jjjjj-enterprises/sienna_camper/window_vent_pattern.pdf

# WAVE 3 Window Vent Panel — full-size cut pattern

Driver-side sliding door, Appendix J (Option B). Panel 34 11/16" x 9 3/4"; intake 6 1/8", exhaust 5 1/16", centers 4 7/8" down, 9 11/32" in from each end, 16" apart.

1. Print double-sided (flip on SHORT edge), Letter, landscape, at 100% / Actual size, NOT Fit. Check the 1" square below.
2. On pages B-D and row 2, cut off the margin on the dashed TRIM line (left edge, and top edge on row 2).
3. Row 1: lay B1's trimmed edge on A1's blue line, match the targets and lines (hold to a window), then C1, D1.
Tape each seam on the back where the backs show the tape strip. Row 2 the same, then onto row 1's bottom strip.
4. Lay the pattern on the poster board with the INSIDE FACE up, square to a factory corner if you can.
Tape it down all round. Hold the overlap's board edge flat where it crosses the intake hole.
5. Cut the outer black line through pattern and board with a box cutter and straightedge.
6. Cut the holes on the red dashed circles first (1/8" small). Open them up to the black line as you fit the collars.
7. Blue dashed lines are where the channels and glass grip the panel. They are not cut lines.
8. Peel the pattern off, or leave it on and write the fit results on it. Then test-fit in the window (Template sheet).

## Assembly map (inside face up, front of the van on the right)

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
## Lines

### cut (final line)

### rough-cut the holes here first

### channel / glass grip, do not cut

### hole center line

1" square:
check with a ruler
before printing the rest

### (back of the title page, left blank)

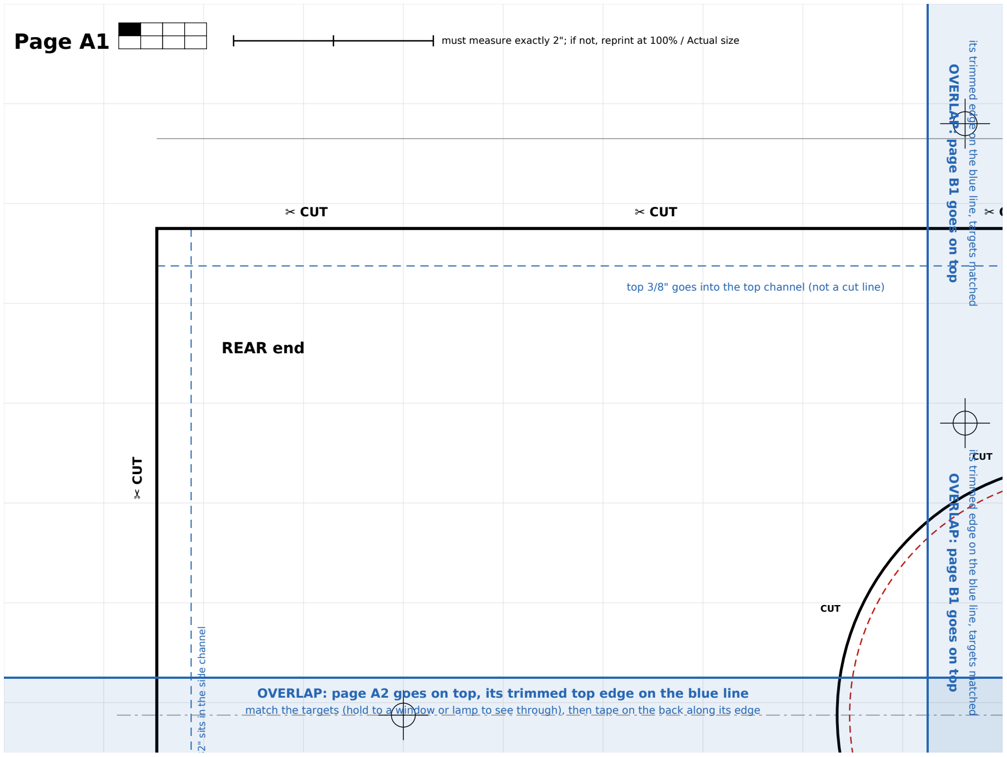
[picture p1: figure]
about 11/32" sits in the side channel; EXHAUST; hole 5 1/16"; rough-cut the red dashed circle first,; CUT; ✂ CUT; OVERLAP: page B1 goes on top

top 3/8" goes into the top channel (not a cut line)

then open up to the black line to fit the collar

REAR end | FRONT end →

its trimmed edge on the blue line, targets matched its trimmed edge on the blue line, targets matched

### OVERLAP: page A2 goes on top, its trimmed top edge on the blue line

match the targets (hold to a window or lamp to see through), then tape on the back along its edge

Page A1 | must measure exactly 2"; if not, reprint at 100% / Actual size

# back of page A1

## the pattern is on the other side · tape the seams on this side

## ◄ TAPE over this edge onto page B1 ◄ TAPE over this edge onto page B1

## ▼ TAPE over this edge onto page A2

If the tape strip isn't along the edge that meets the next page, your printer flipped the other way: tape along that edge anyway.

top 3/8" goes into the top channel (not a cut line)

top 3/8" goes into the top channel (not a cut line)

# EXHAUST

## hole 5 1/16"

rough-cut the red dashed circle first,

then open up to the black line to fit the collar

center

CUT | CUT

CUT

### ✂ CUT

### ✂ CUT

### ✂ CUT

REAR end | FRONT end →

panel 34 11/16" x 9 3/4" · holes 4 7/8" down, 9 11/32" in from each end OVERLAP: page C1 goes on top its trimmed edge on the blue line, targets matched OVERLAP: page C1 goes on top its trimmed edge on the blue line, targets matched

### OVERLAP: page B2 goes on top, its trimmed top edge on the blue line

match | the targets (hold to a window or lamp | to see through), then tape on the back along its edge

✂ TRIM on the dashed line ✂ TRIM on the dashed line ✂ TRIM on the dashed line

then lay this edge on the blue line of page A1

Page B1 | must measure exactly | 2"; if not, reprint at 100% / Actual size

# back of page B1

## the pattern is on the other side · tape the seams on this side

## ◄ TAPE over this edge onto page C1 ◄ TAPE over this edge onto page C1

## ▼ TAPE over this edge onto page B2

top 3/8" goes into the top channel (not a cut line)

top 3/8" goes into the top channel (not a cut line)

then open up to the black line to fit the collar

| | | | CUT | | | CUT
| | CUT | | | INTAKE
| OVERLAP: page C2 goes on | top, its trimmed top edge on the blue line | | | hole 6 1/8"
match the targets (hold to a window or | | | lamp to see through), then tape on the back along its edge
| | | | | rough-cut the red dashed circle first, | center

### ✂ CUT

### ✂ CUT

### ✂ CUT

REAR end | FRONT end →

### panel 34 11/16" x 9 3/4" · holes 4 7/8" down, 9 11/32" in from each end

### OVERLAP: page D1 goes on top

its trimmed edge on the blue line, targets matched

### OVERLAP: page D1 goes on top

its trimmed edge on the blue line, targets matched

✂ TRIM on the dashed line ✂ TRIM on the dashed line ✂ TRIM on the dashed line

then lay this edge on the blue line of page B1

Page C1 | must measure exactly 2"; if not, reprint at 100% / Actual size

# back of page C1

## the pattern is on the other side · tape the seams on this side

## ◄ TAPE over this edge onto page D1 ◄ TAPE over this edge onto page D1

## ▼ TAPE over this edge onto page C2

top 3/8" goes into the top channel (not a cut line)

about 11/32" sits in the side channel

## hole 6 1/8"

rough-cut the red dashed circle first,

then open up to the black line to fit the collar

CUT | CUT

CUT

### ✂ CUT

### ✂ CUT

### ✂ CUT

### ✂ CUT

REAR end | FRONT | end →

(your right, from inside the van)

OVERLAP: | page D2 goes | on top, its trimmed top edge on the blue line
match the targets (hold to a window or lamp to see through), then tape on the back along its edge

✂ TRIM on the dashed line ✂ TRIM on the dashed line ✂ TRIM on the dashed line

then lay this edge on the blue line of page C1

Page D1 | must measure exactly 2"; if not, reprint at 100% / Actual size

# back of page D1

## the pattern is on the other side · tape the seams on this side

## ▼ TAPE over this edge onto page D2

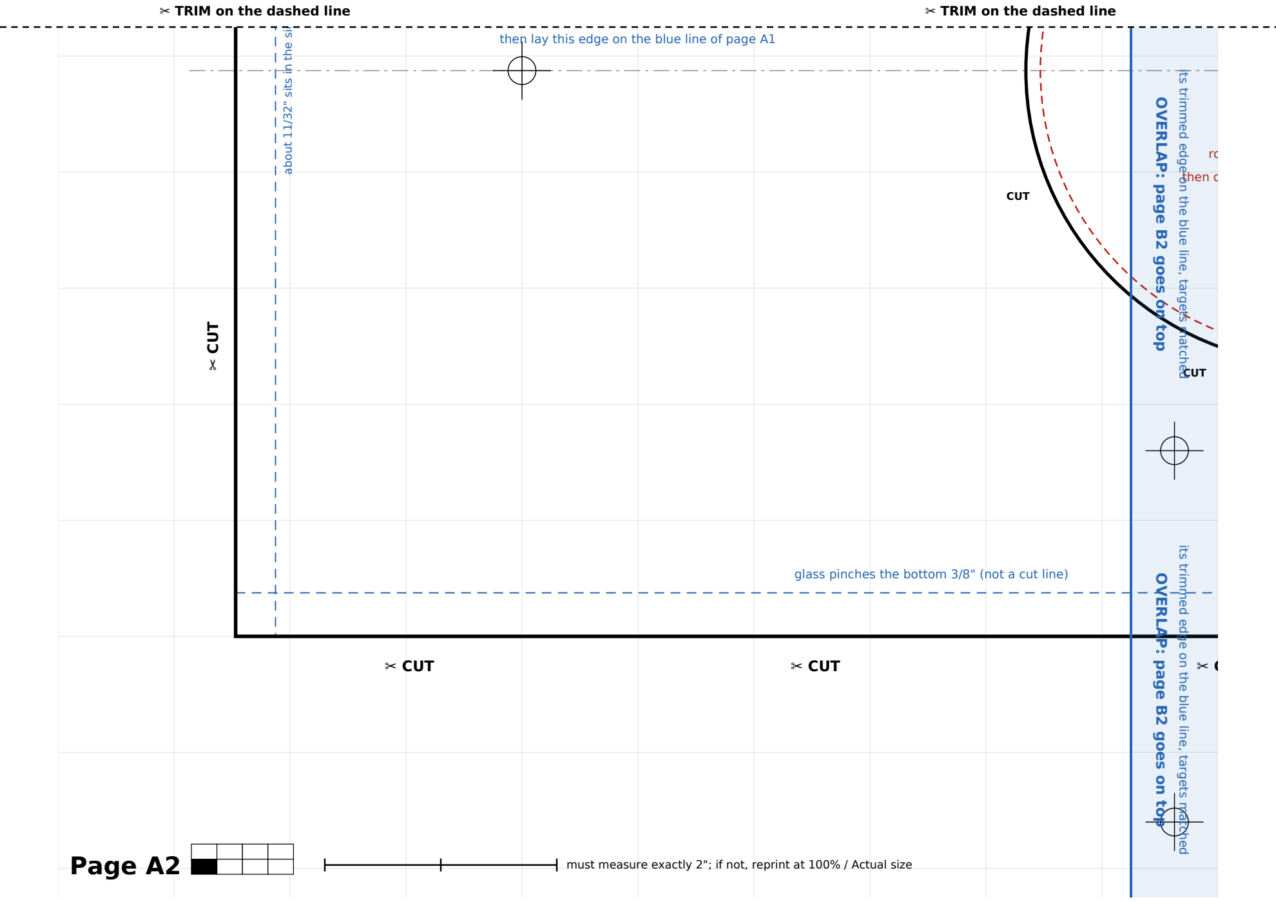
[picture p2: figure]
about 11/32" sits in the side channel; rough-cut the red dashed circle first,; CUT; ✂ CUT; OVERLAP: page B2 goes on top

glass pinches the bottom 3/8" (not a cut line) then open up to the black line to fit the collar

its trimmed edge on the blue line, targets matched its trimmed edge on the blue line, targets matched

✂ | TRIM on the dashed line | ✂ TRIM on the dashed line

then lay this edge on the blue line of page A1

Page A2 | must measure exactly 2"; if not, reprint at 100% / Actual size

# back of page A2

## the pattern is on the other side · tape the seams on this side

## ◄ TAPE over this edge onto page B2 ◄ TAPE over this edge onto page B2

glass pinches the bottom 3/8" (not a cut line) rough-cut the red dashed circle first,

then open up to the black line to fit the collar

center

CUT

CUT | CUT

### ✂ CUT

### ✂ CUT

### ✂ CUT

INSIDE | FACE
centers 16" | apart (check with a tape)

panel 34 11/16" x 9 3/4" · holes 4 7/8" down, 9 11/32" in from each end OVERLAP: page C2 goes on top its trimmed edge on the blue line, targets matched OVERLAP: page C2 goes on top its trimmed edge on the blue line, targets matched

✂ TRIM on the dashed line ✂ TRIM on the dashed line ✂ TRIM on the dashed line

then lay this edge on the blue line of page A2

✂ TRIM on the | dashed line | ✂ TRIM on the dashed line
then lay this edge | on the blue line of page B1
Page B2 | must measure exactly | 2"; if not, reprint at 100% / Actual size

# back of page B2

## the pattern is on the other side · tape the seams on this side

## ◄ TAPE over this edge onto page C2 ◄ TAPE over this edge onto page C2

glass pinches the bottom 3/8" (not a cut line)

glass pinches the bottom 3/8" (not a cut line)

| rough-cut the red dashed circle first, | center
CUT | then open up to the black line to fit the | | collar
CUT | CUT

### ✂ CUT

### ✂ CUT

### ✂ CUT

INSIDE | FACE
centers 16" | apart (check with a tape)

### OVERLAP: page D2 goes on top

its trimmed edge on the blue line, targets matched

### OVERLAP: page D2 goes on top

its trimmed edge on the blue line, targets matched

✂ TRIM on the dashed line ✂ TRIM on the dashed line ✂ TRIM on the dashed line

then lay this edge on the blue line of page B2

✂ TRIM on the dashed line | ✂ TRIM on the dashed line
then lay this | edge on the blue line of page C1
Page C2 | must measure exactly 2"; if not, reprint at 100% / Actual size

# back of page C2

## the pattern is on the other side · tape the seams on this side

## ◄ TAPE over this edge onto page D2 ◄ TAPE over this edge onto page D2

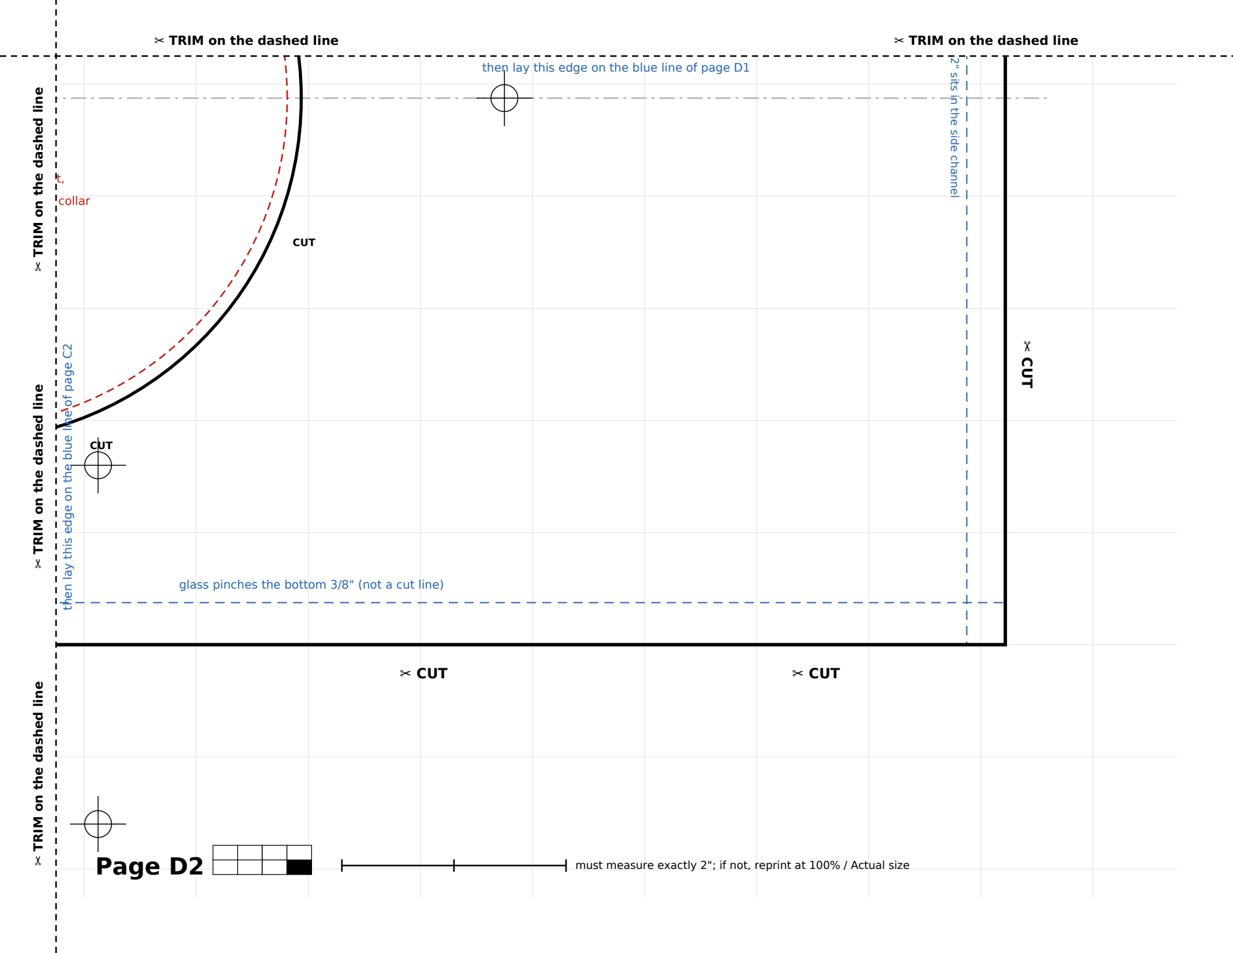
[picture p3: figure]
about 11/32" sits in the side channel; rough-cut the red dashed circle first,; CUT; ✂ CUT; ✂ TRIM on the dashed; line; ✂ TRIM on; the dashed line

glass pinches the bottom 3/8" (not a cut line) then open up to the black line to fit the collar

✂ TRIM on the dashed line ✂ TRIM on the dashed line ✂ TRIM on the dashed line

then lay this edge on the blue line of page C2

then lay | this edge on the blue line of page D1
Page D2 | must measure exactly 2"; if not, reprint at 100% / Actual size

# back of page D2

## the pattern is on the other side · tape the seams on this side

## nothing to tape from this page: tape from C2 and D1 lands here
