jjjjj-enterprises/sienna_camper/photos/ply-02-comb-laid-out.jpg

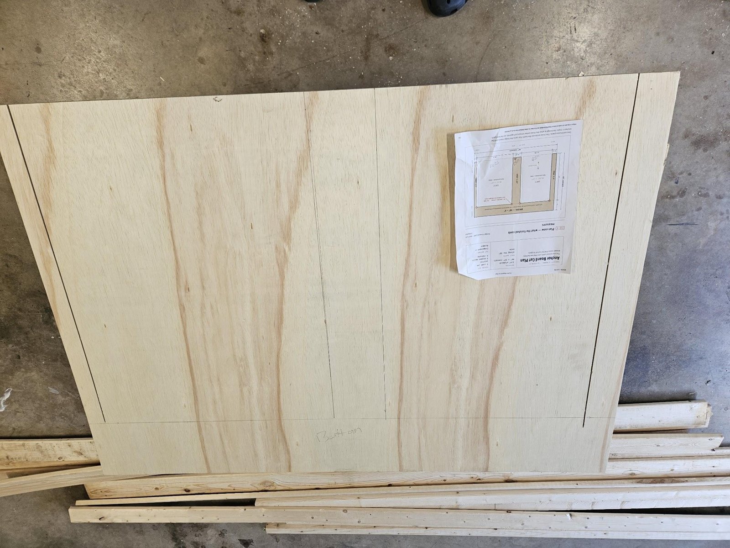
photos/ply-02-comb-laid-out.jpg
