jjjjj-enterprises/sienna_camper/photos/ply-05-comb-cut.jpg

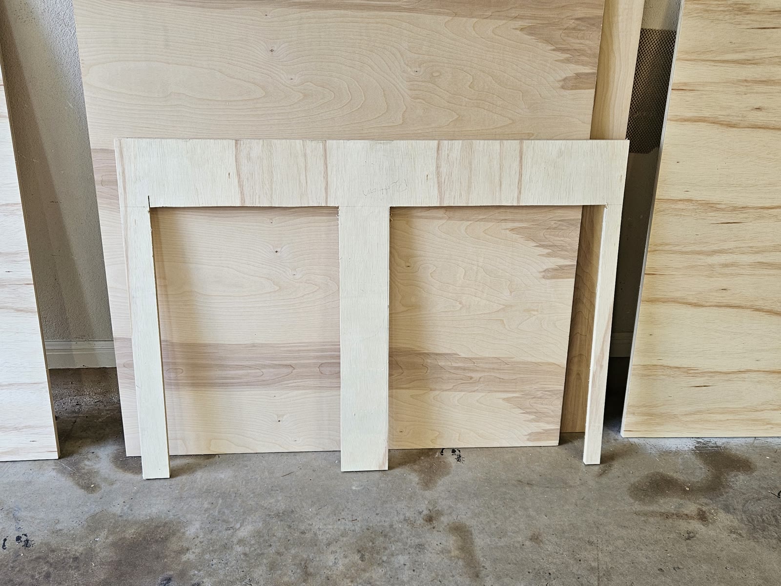
photos/ply-05-comb-cut.jpg
