jjjjj-enterprises/sienna_camper/renders/rear-view-deployed.png

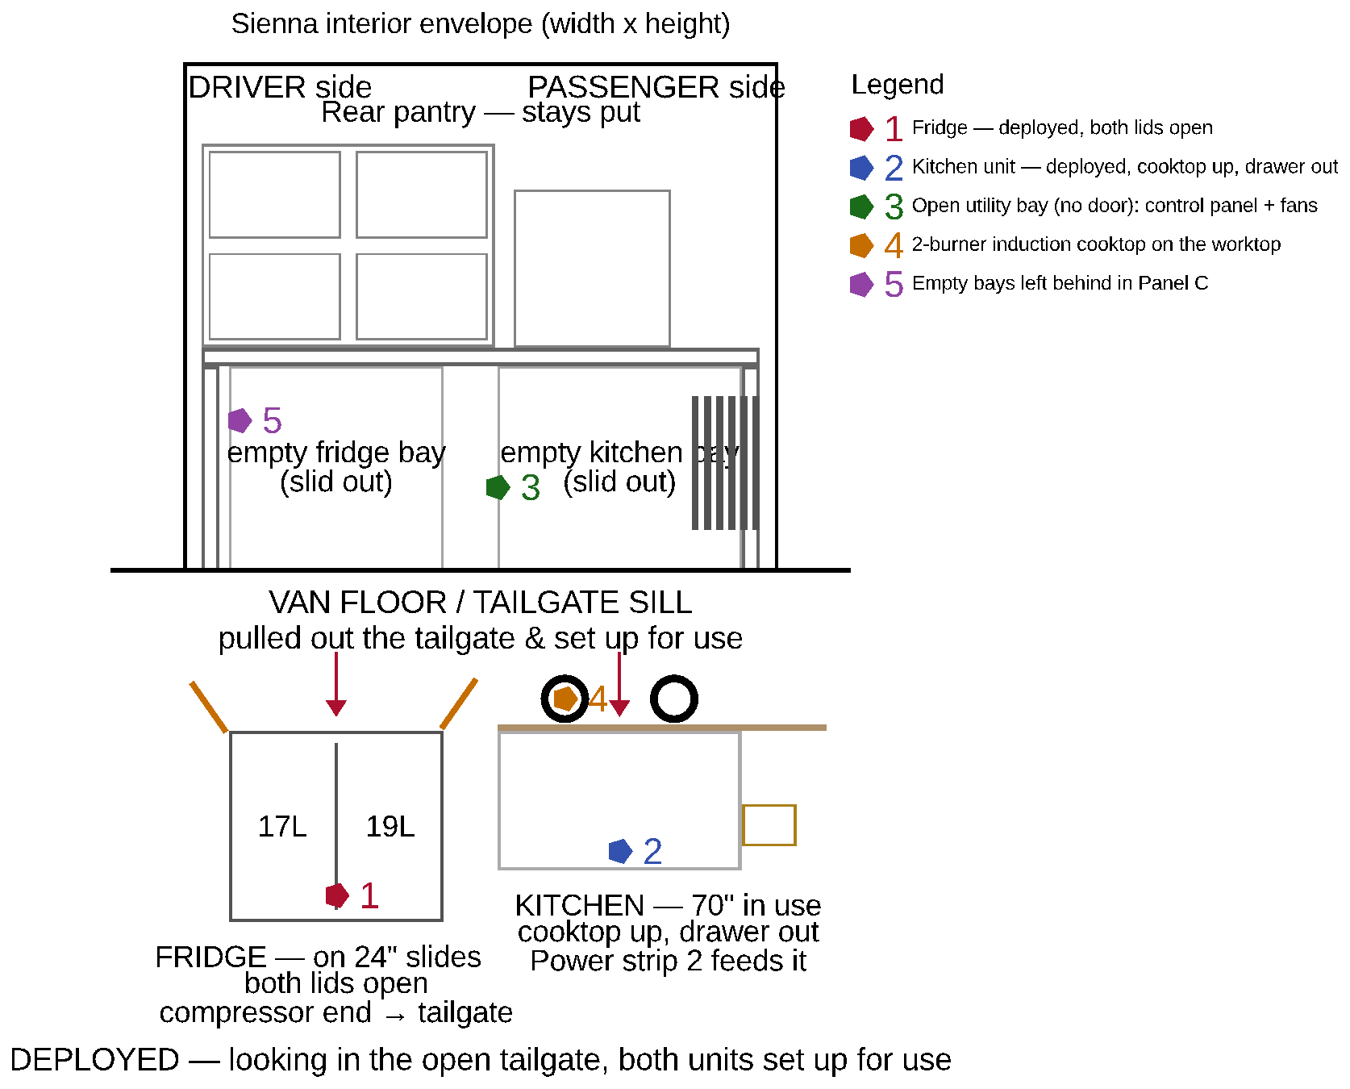
renders/rear-view-deployed.png
