jjjjj-enterprises/sienna_camper/renders/rear-view.png

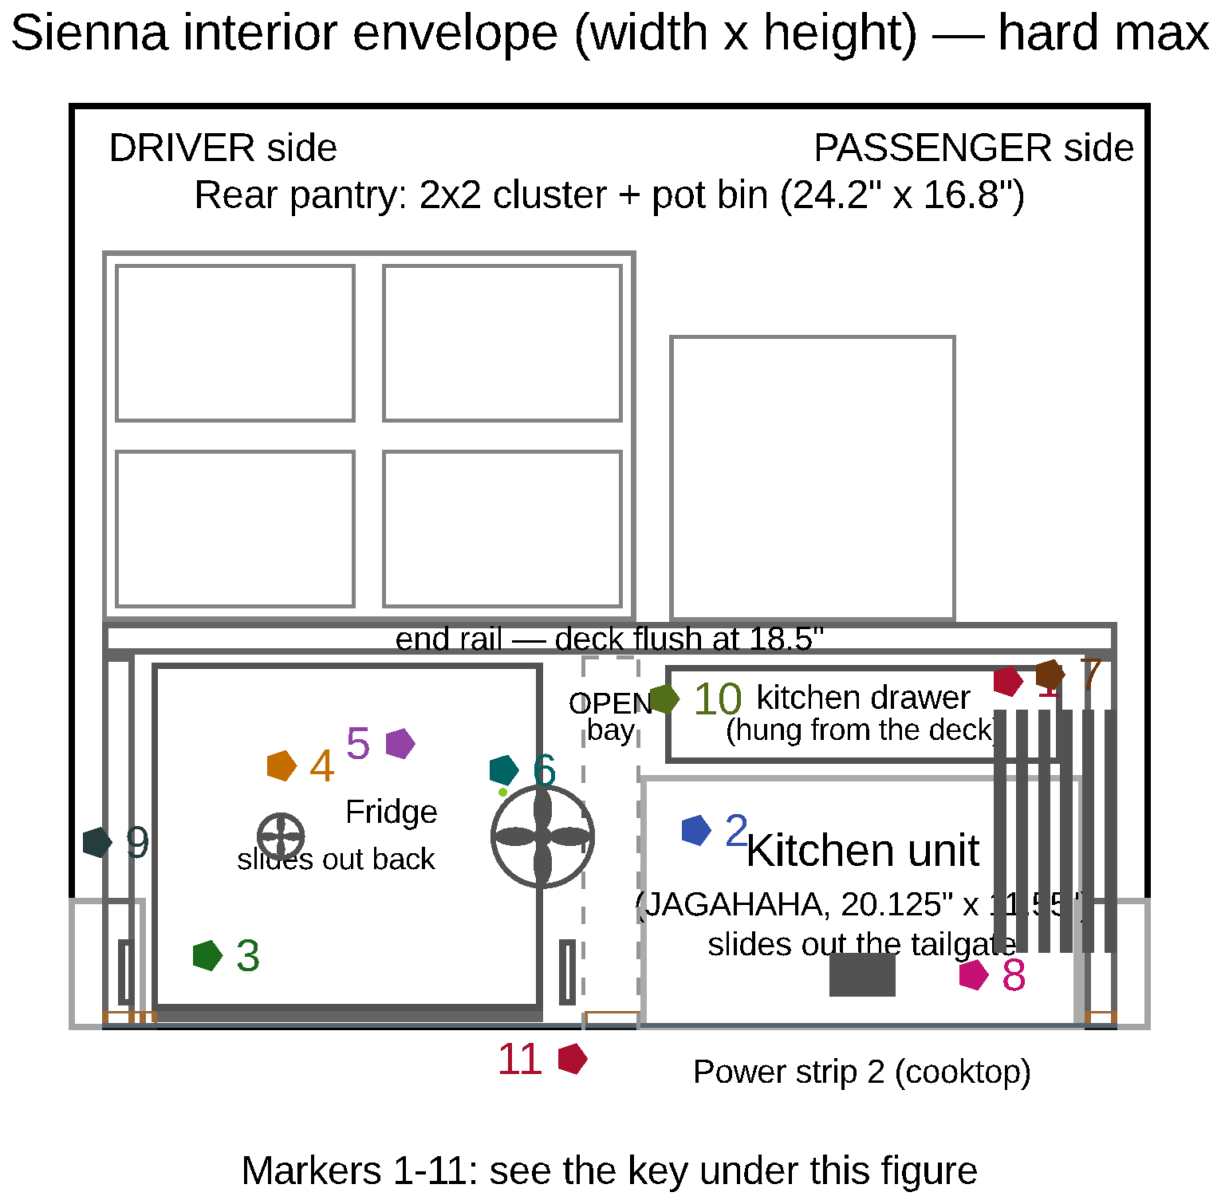
renders/rear-view.png
