jjjjj-enterprises/sienna_camper/renders/sheet-cut-1.png

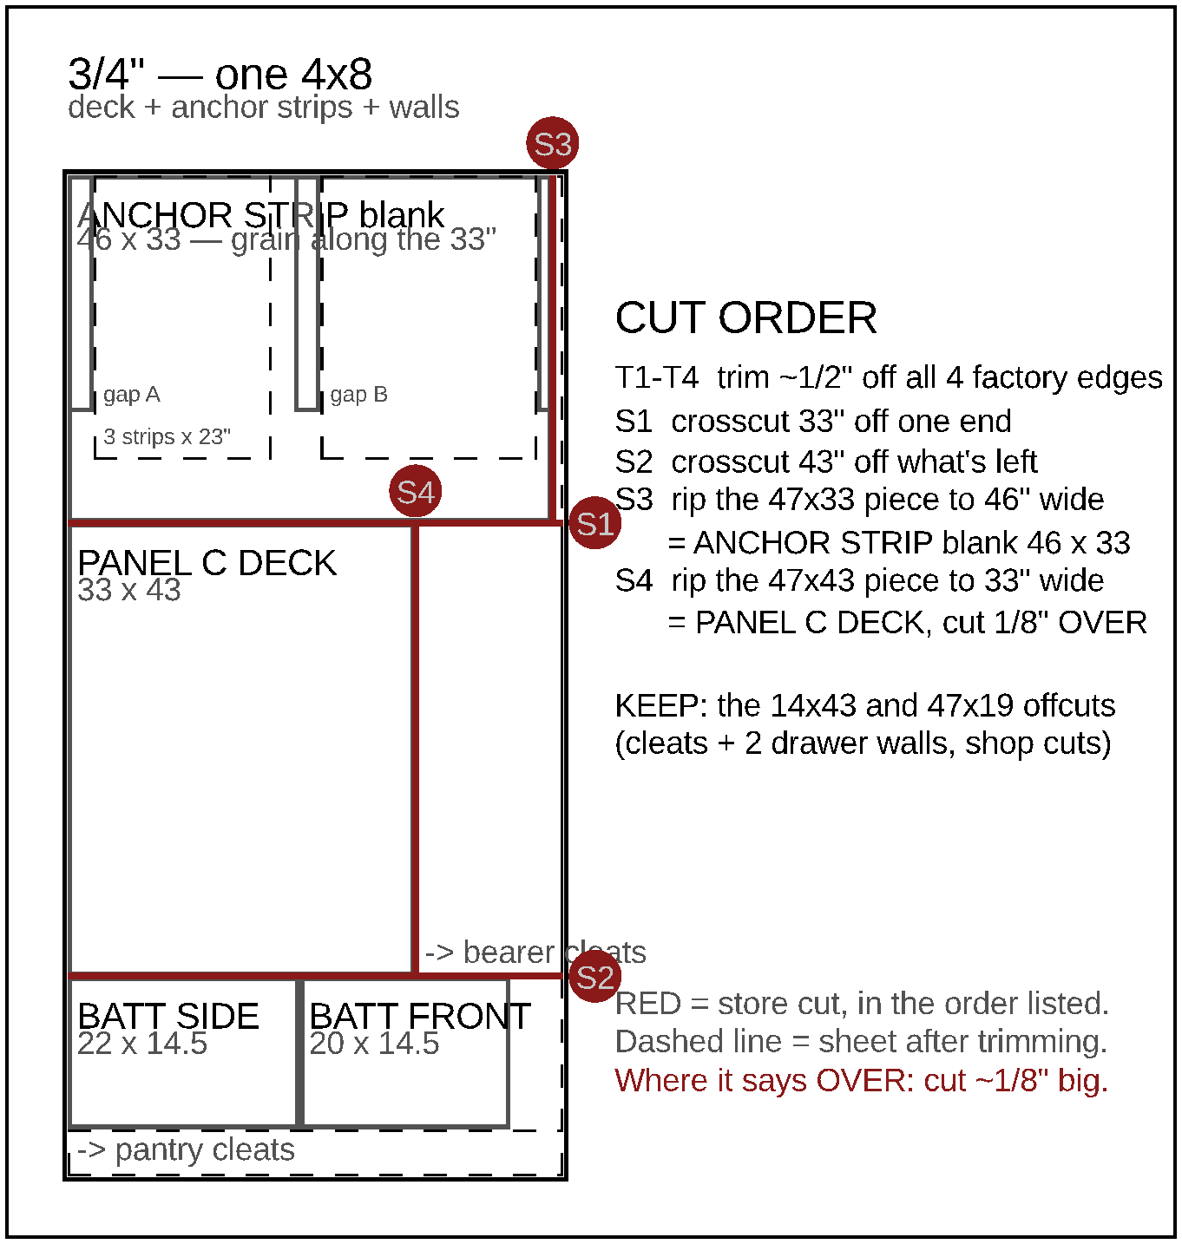
renders/sheet-cut-1.png
