jjjjj-enterprises/sienna_camper/renders/sheet-cut-layout.png

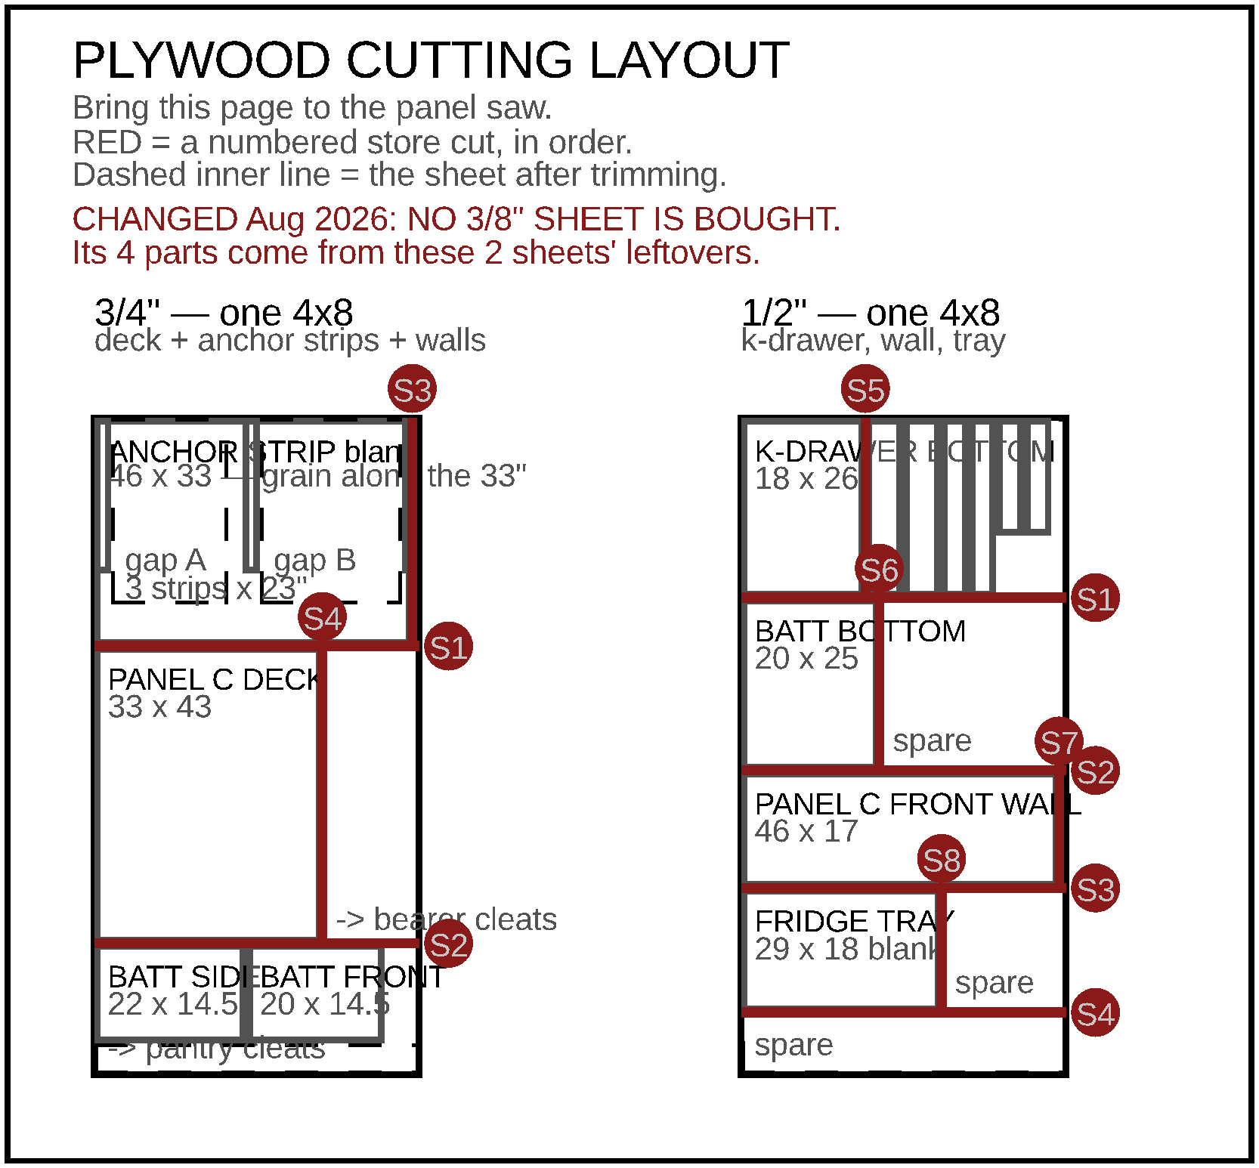
renders/sheet-cut-layout.png
