jjjjj-enterprises/sienna_camper/renders/side-driver.png

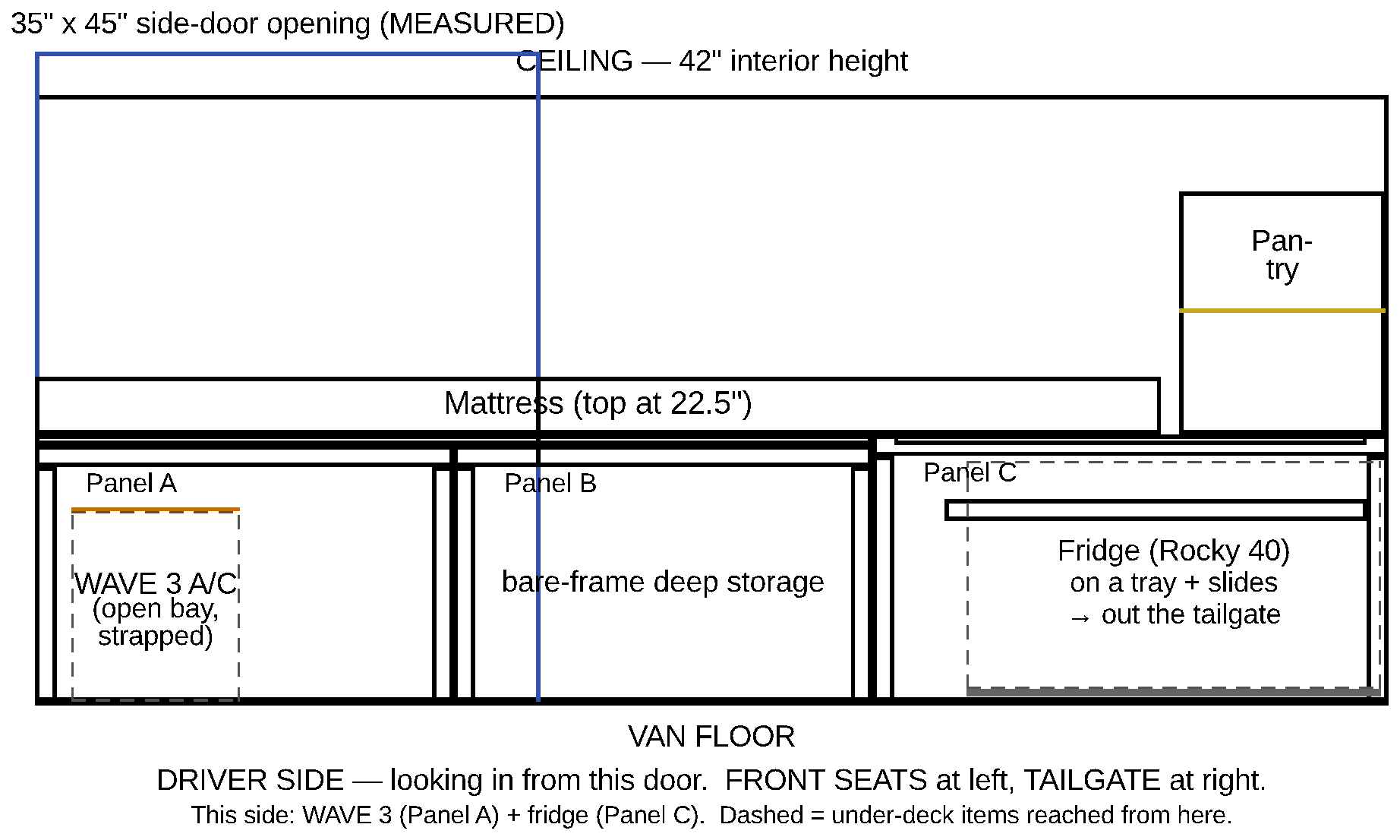
renders/side-driver.png
