jjjjj-enterprises/sienna_camper/renders/side-profile.png

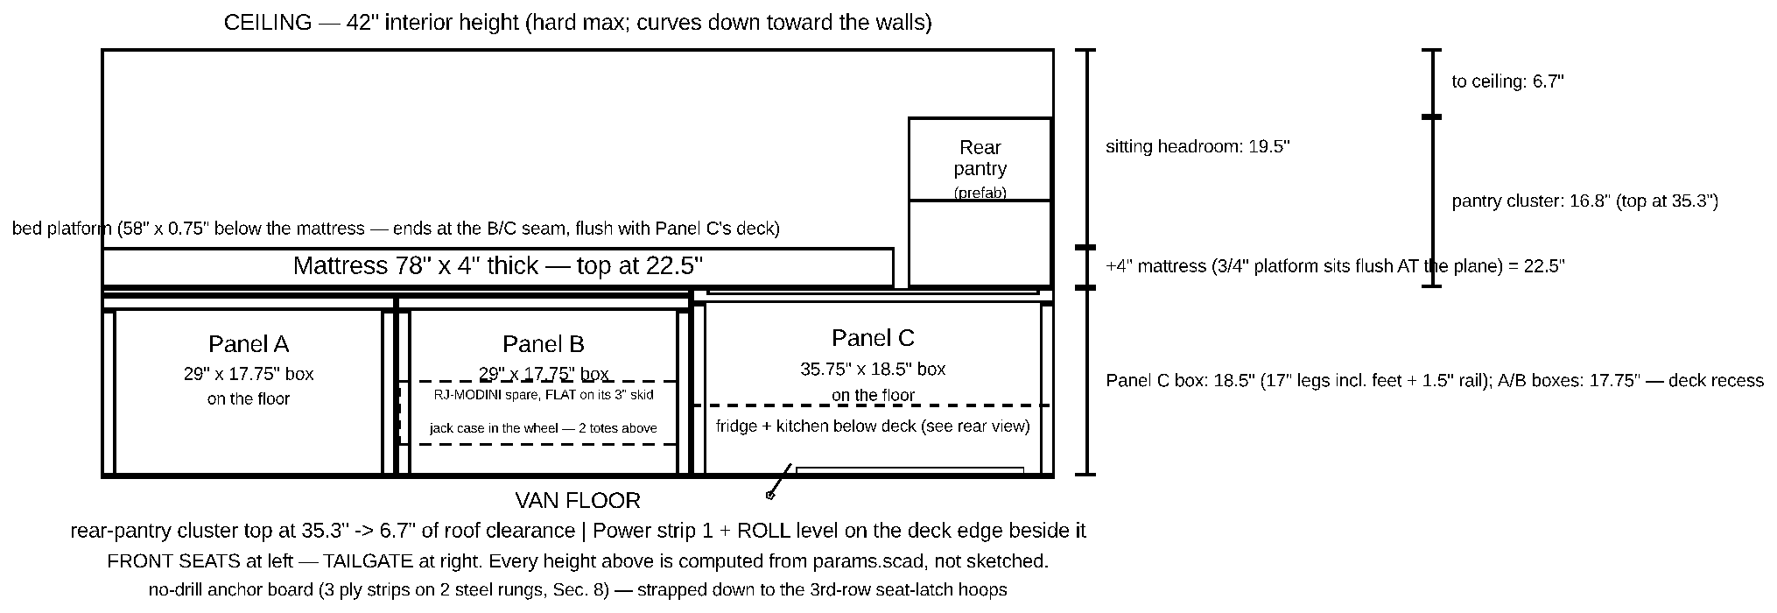
renders/side-profile.png
