jjjjj-enterprises/sienna_camper/renders/top-down.png

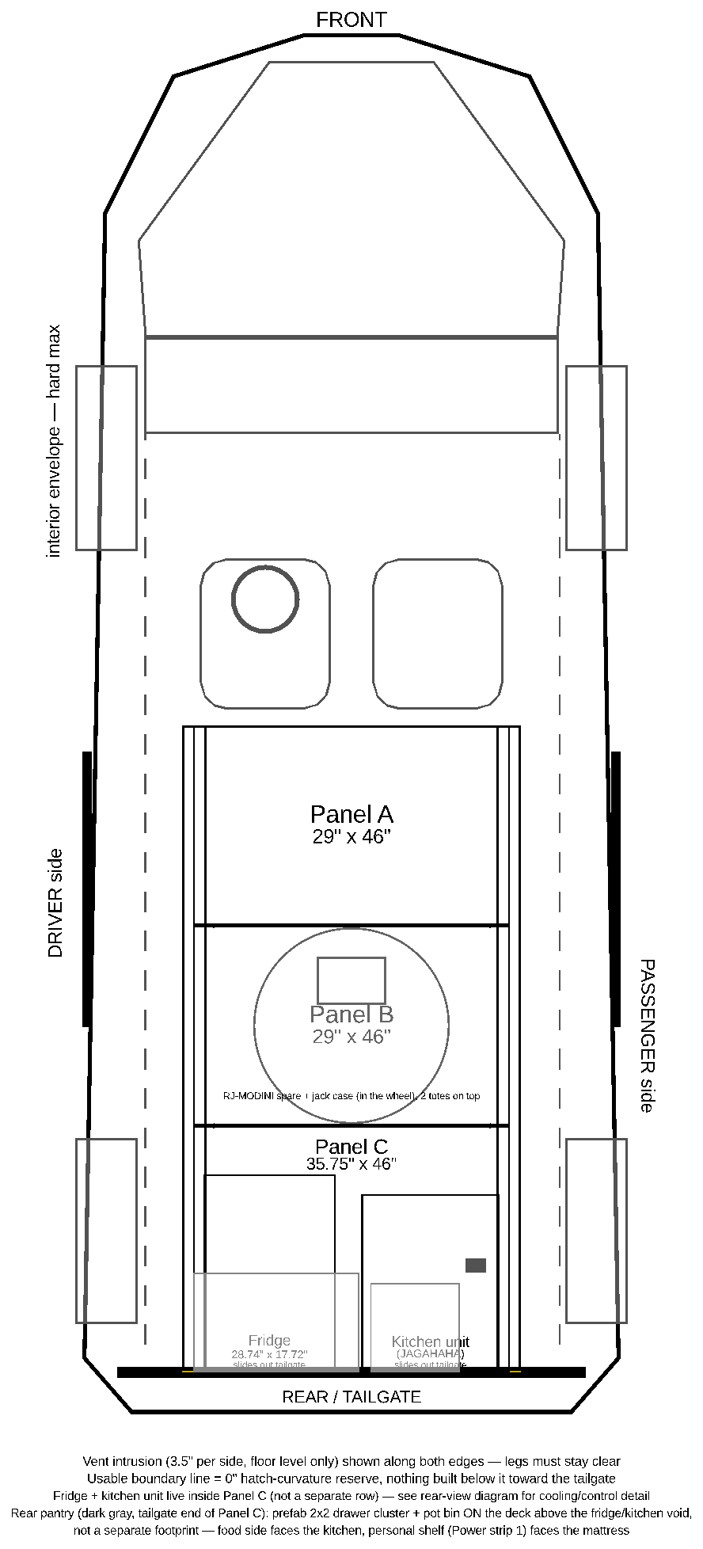
renders/top-down.png
