jjjjj-enterprises/sienna_camper/renders/vanmeas-v1.png

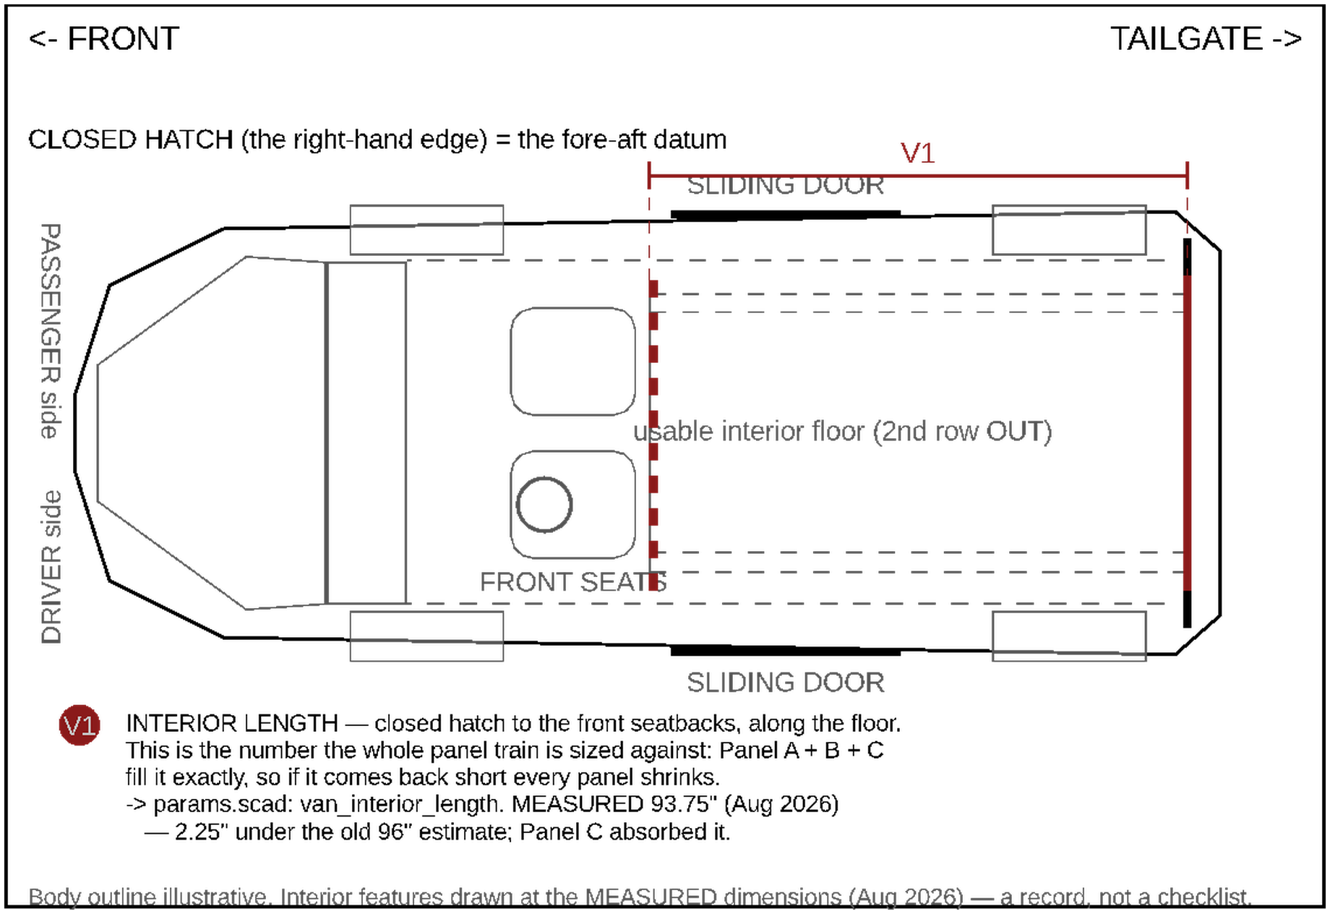
renders/vanmeas-v1.png
