jjjjj-enterprises/sienna_camper/renders/vanmeas-v2.png

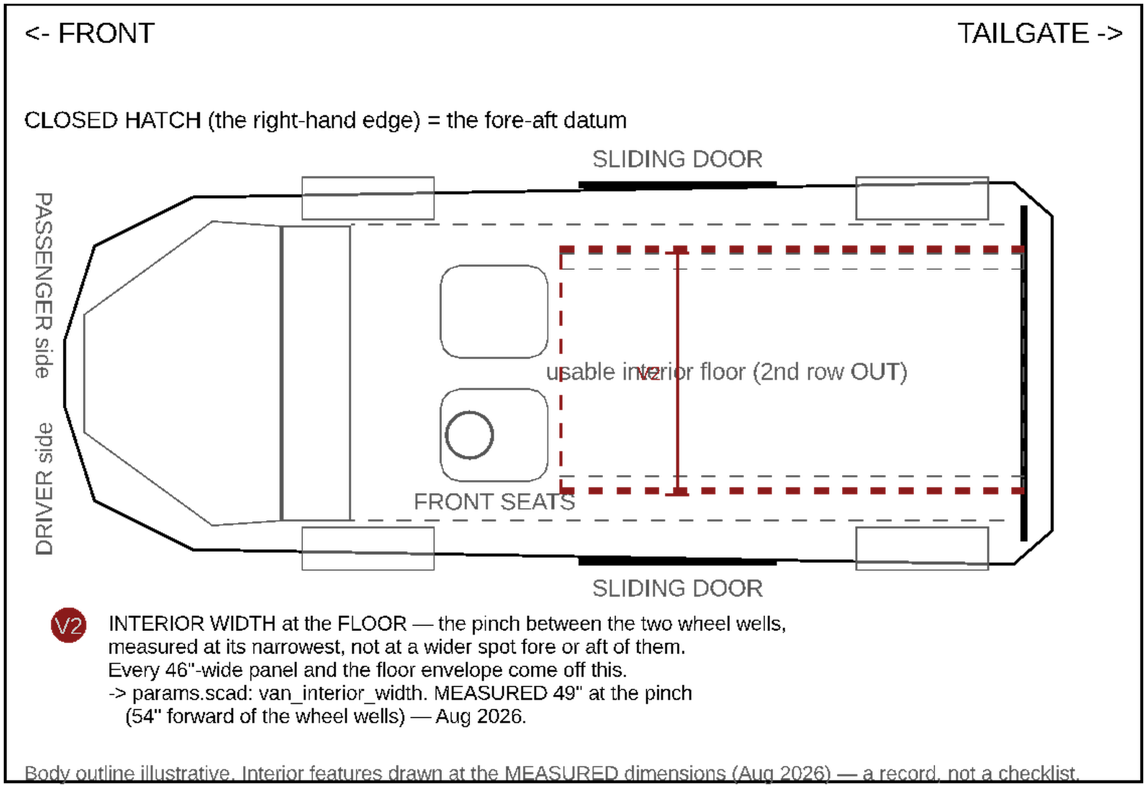
renders/vanmeas-v2.png
