jjjjj-enterprises/sienna_camper/renders/vanmeas-v3.png

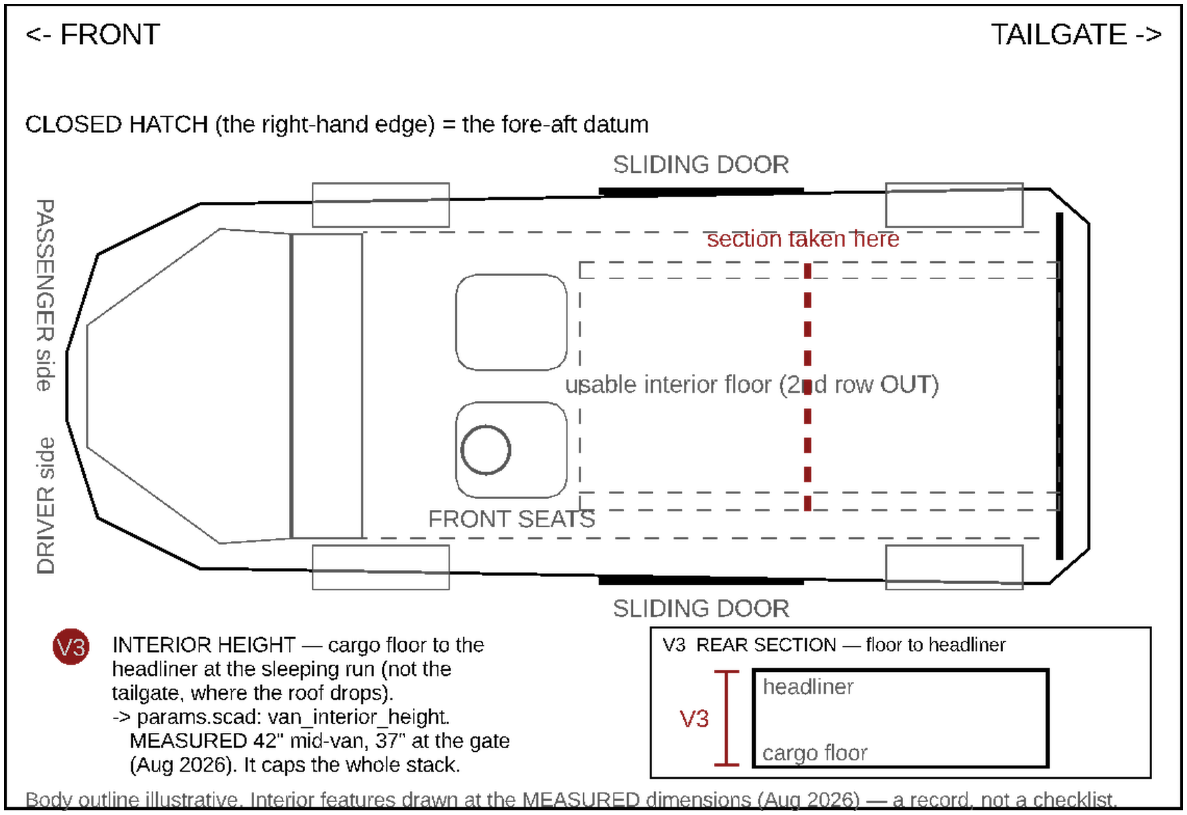
renders/vanmeas-v3.png
