jjjjj-enterprises/sienna_camper/renders/vanmeas-v4.png

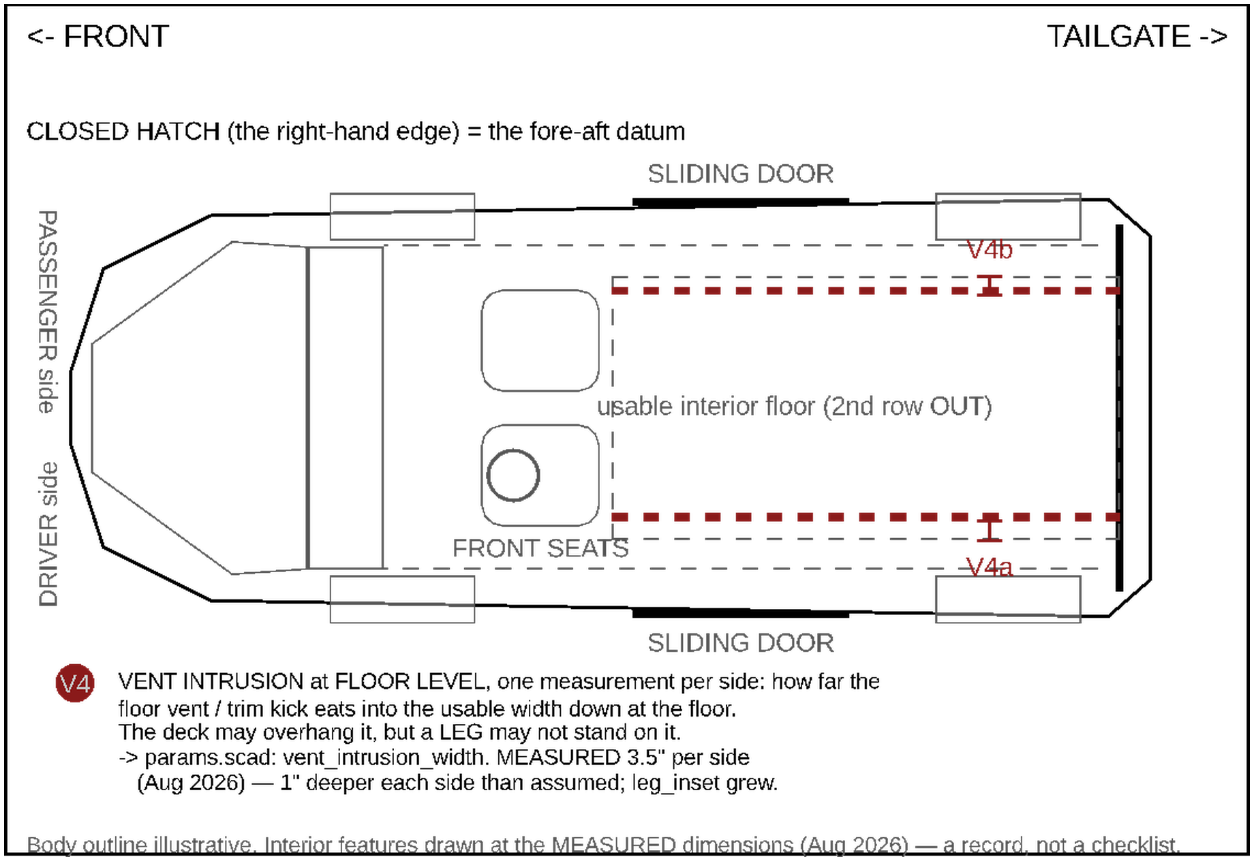
renders/vanmeas-v4.png
