jjjjj-enterprises/sienna_camper/renders/vanmeas-v5.png

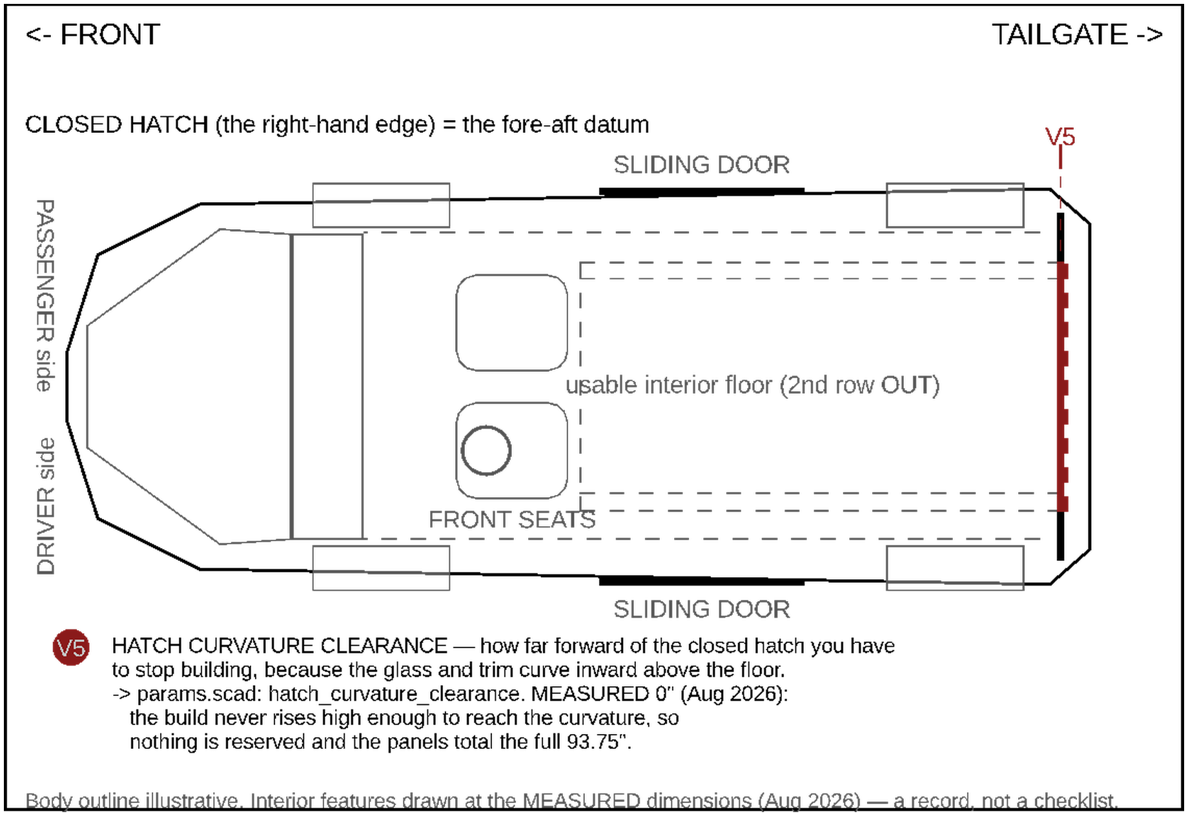
renders/vanmeas-v5.png
