jjjjj-enterprises/sienna_camper/renders/vanmeas-v6.png

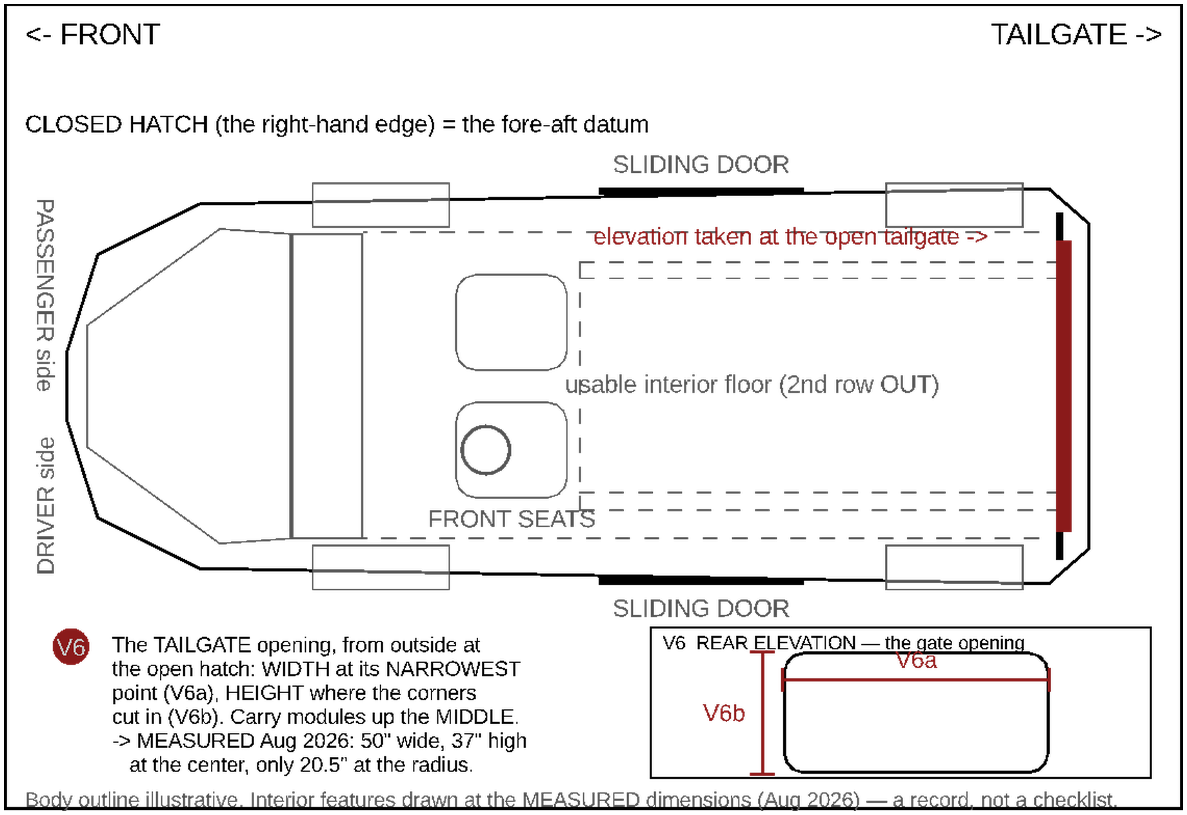
renders/vanmeas-v6.png
