jjjjj-enterprises/sienna_camper/renders/vanmeas-v7.png

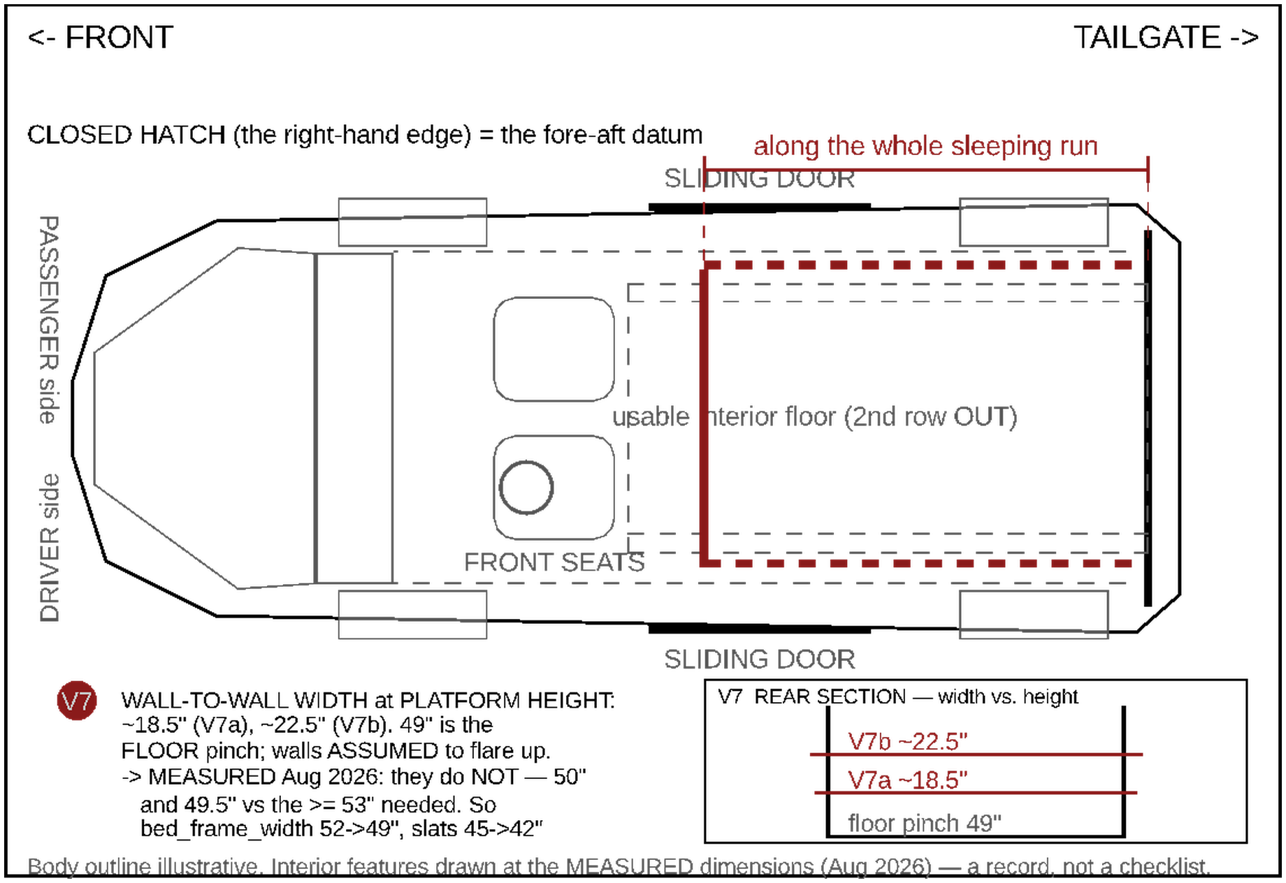
renders/vanmeas-v7.png
