jjjjj-enterprises/sienna_camper/renders/vanmeas-v8.png

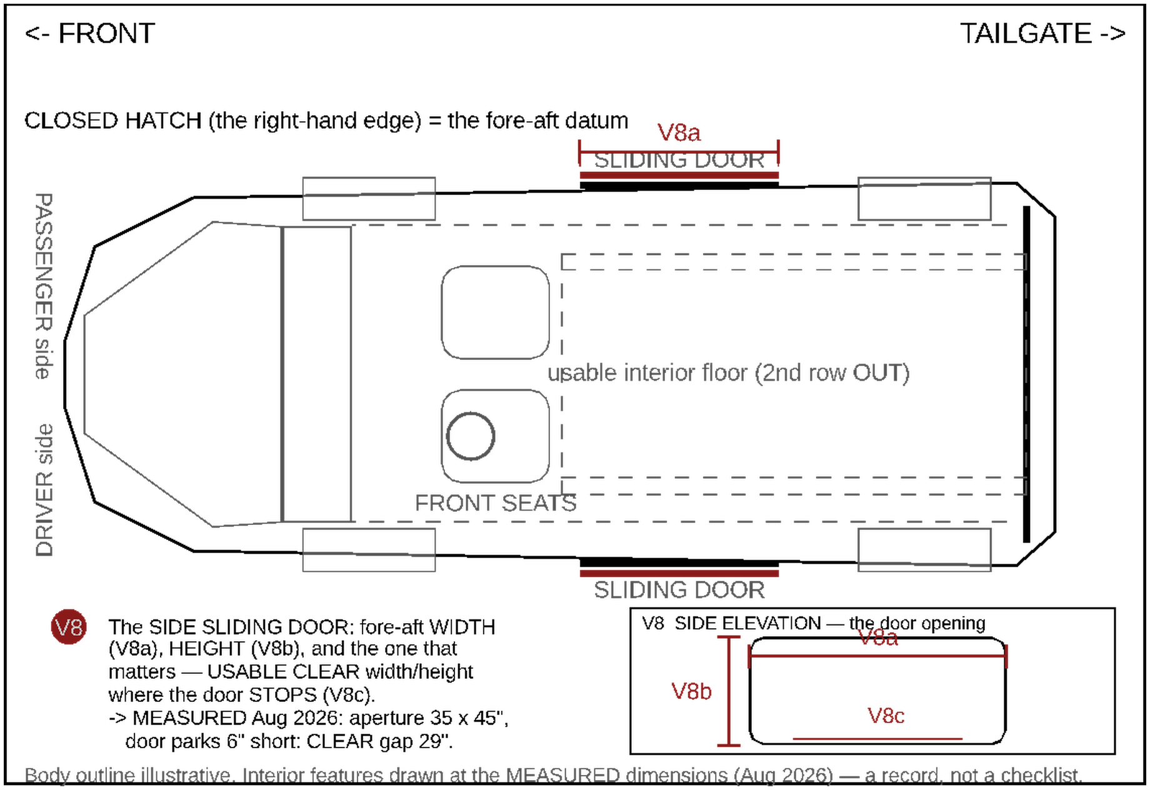
renders/vanmeas-v8.png
