jjjjj-enterprises/sienna_camper/renders/vanmeas-v9.png

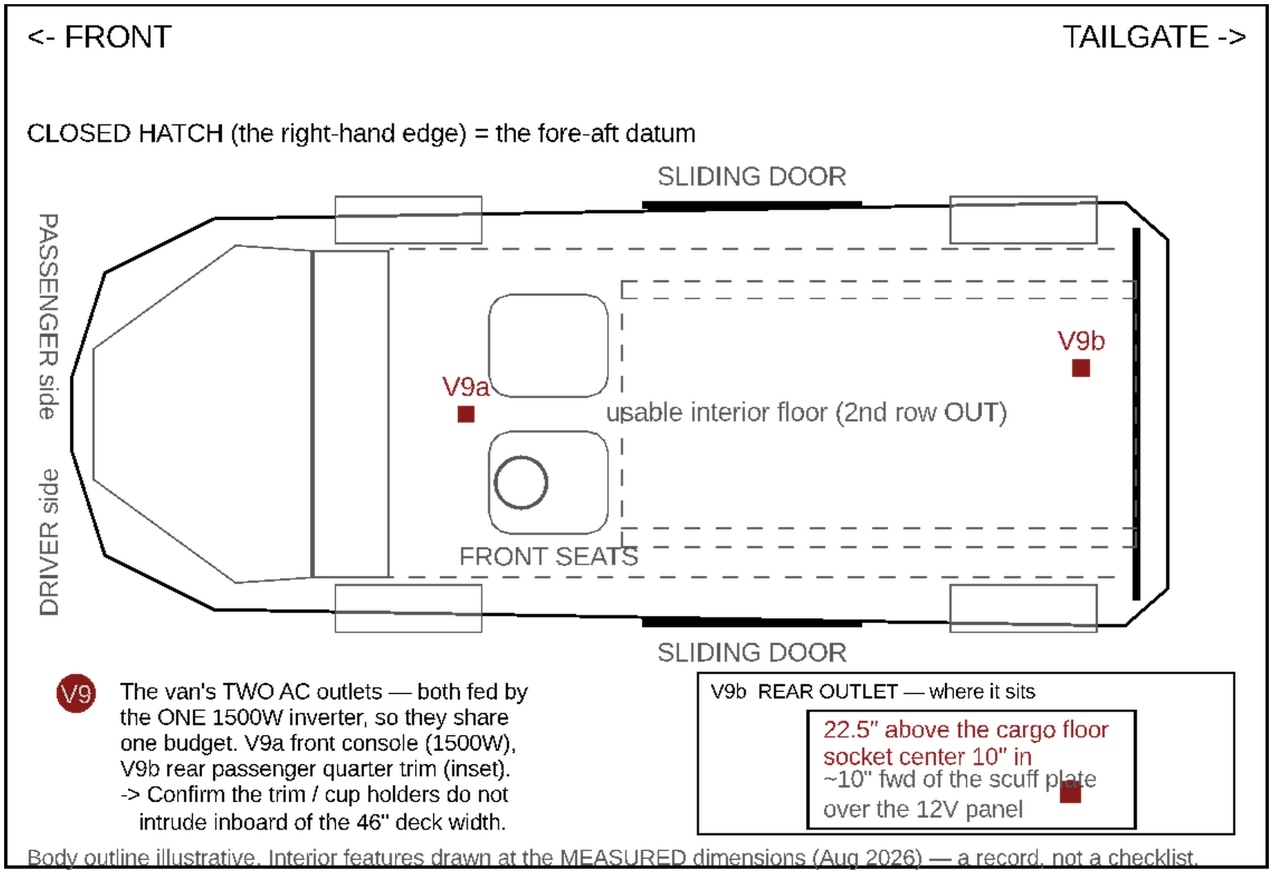
renders/vanmeas-v9.png
