jjjjj-enterprises/sienna_camper/renders/vanmeas-v10.png

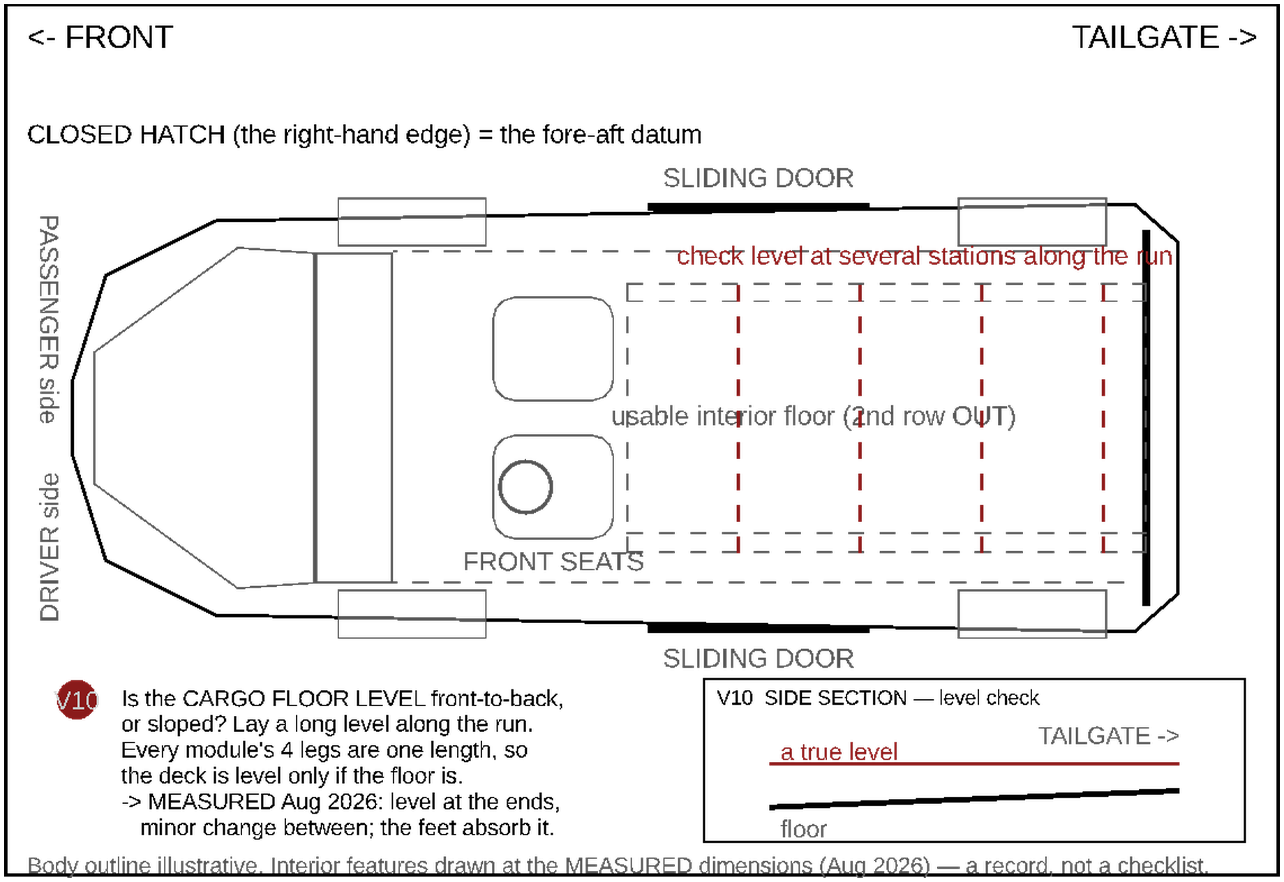
renders/vanmeas-v10.png
