jjjjj-enterprises/sienna_camper/electrical_layout_detail.scad

// ============================================================
// Electrical system layout — icon-based, all purchased parts
// ============================================================
// Every electrical component bought for the build (fans, W1209
// controller, Nilight fuse block, switches, enclosure, SAE
// cables, grommets, power strips),
// drawn as a recognizable icon at its REAL position:
//
//   SECTION 1: whole-platform top-down — where everything lives
//   SECTION 2: open utility bay back elevation (X-Z) — how
//              the control cluster mounts
//   SECTION 3: fan mounting detail — screw pattern + airflow
//              direction for both fans
//
// Numbered markers use the shared hue-coded palette
// (colors.scad) and pair with the side legend, same convention
// as the other detail views.
//
// SECTION 1 COORDS: X 0-46 left to right (standing at the
// tailgate facing forward), Y 0 at Panel A's front edge (flush
// with the front seatbacks) increasing toward the tailgate (94
// total).
//
// Render with: openscad -o renders/electrical-layout.svg electrical_layout_detail.scad
// ============================================================
// LEGIBILITY (Aug 2026): 15 prose line(s) moved out of this
// sheet into the document, and every text size scaled x2.0. Those
// sentences were setting the sheet's width, and a figure's printed
// text height is size x (page_width / sheet_width) — so they were
// holding every other label on the sheet down to 3-6pt on paper.
// Keep prose in the markdown; this sheet carries geometry and short
// labels only.

include <params.scad>
include <colors.scad>

stroke = 0.25;

module rect_outline(w, l, s = stroke) {
    color("black")
    difference() {
        square([w, l]);
        translate([s, s]) square([w - 2*s, l - 2*s]);
    }
}

module label(txt, x, y, size = 2.8) {
    color("black") translate([x, y]) text(txt, size = size, halign = "center", valign = "center");
}
module label_left(txt, x, y, size = 2.4) {
    color("black") translate([x, y]) text(txt, size = size, halign = "left", valign = "center");
}
// The numeral goes BESIDE the icon, not on it: a filled circle and the
// numeral inside it touch, and OpenSCAD merges touching 2D shapes into one
// polygon painted a single colour — the numbers were rendering as ghosts
// over their own icons.
module marker(n, x, y) {
    translate([x, y]) {
        color(marker_col(n)) circle(r = 1.5);
        // LEFT of the icon: the legend's own text starts just to the right of
        // it, so a numeral on that side lands on top of the description.
        color(marker_col(n)) translate([-2.4, 0])
            text(str(n), size = 3.0, halign = "right", valign = "center");
    }
}
// Counter-mirrored text emitters for the MIRRORED top-down section:
// section 1 is drawn inside mirror([1,0,0]) so the tailgate-at-top
// bird's-eye puts the PASSENGER side on the page LEFT (a real
// overhead view, not a mirror image). These re-mirror just the
// glyphs so the text stays readable; centered text stays centered.
module mlabel(txt, x, y, size = 2.8) {
    color("black") translate([x, y]) mirror([1, 0, 0]) text(txt, size = size, halign = "center", valign = "center");
}
// Numeral BESIDE the icon. A white numeral centered in a filled circle vanishes:
// OpenSCAD merges touching 2D shapes into one polygon set and paints them one
// colour. The plan is drawn MIRRORED, so the mirror goes outside the offset —
// which puts the numeral on the icon's left as seen on the sheet.
module mmarker(n, x, y, nx = 1.9) {
    translate([x, y]) {
        color(marker_col(n)) circle(r = 1.2);
        color(marker_col(n)) mirror([1, 0, 0]) translate([nx, 0])
            text(str(n), size = 2.6, halign = "left", valign = "center");
    }
}
module wire(pts, w = 0.28, col = "Black") { // solid polyline
    color(col) for (i = [0 : len(pts) - 2])
        hull() { translate(pts[i]) circle(w); translate(pts[i+1]) circle(w); }
}

// ---- component icons -------------------------------------------
module fan_icon(r = 2.2) { // square frame, blades, hub, 4 screws
    color("DimGray") difference() {
        square([2*r + 1, 2*r + 1], center = true);
        circle(r = r);
    }
    color("DarkGray") for (a = [0, 90, 180, 270])
        rotate(a) translate([r*0.45, 0]) scale([1, 0.45]) circle(r = r*0.5);
    color("DimGray") circle(r = r*0.3);
    color("Black") for (sx = [-1, 1]) for (sy = [-1, 1])
        translate([sx*(r + 0.15), sy*(r + 0.15)]) circle(r = 0.22);
}
module strip_icon(n = 4, horiz = true) { // power strip w/ outlets
    w = n * 1.6 + 1;
    rotate(horiz ? 0 : 90) {
        color("Black") square([w, 2.2], center = true);
        color("White") for (i = [0 : n - 1])
            translate([-w/2 + 1.3 + i * 1.6, 0]) square([1.0, 1.3], center = true);
    }
}
module fusebox_icon() { // Nilight 6-way: 2 cols x 3 fuses
    color("DimGray") square([3.4, 4.4], center = true);
    for (i = [0:2]) for (s = [-1, 1])
        color(i == 0 ? "Crimson" : i == 1 ? "Goldenrod" : "RoyalBlue")
            translate([s * 0.8, -1.2 + i * 1.2]) square([0.9, 0.7], center = true);
}
module w1209_icon() { // PCB + red 3-digit display + relay
    color("SeaGreen") square([4.4, 2.8], center = true);
    color("Black") translate([-0.7, 0]) square([2.2, 1.3], center = true);
    color("Crimson") translate([-0.7, 0]) text("26.0", size = 1.8, halign = "center", valign = "center");
    color("RoyalBlue") translate([1.6, 0]) square([0.9, 1.8], center = true);
}
module switch_icon() { // round illuminated rocker
    color("Black") circle(r = 0.85);
    color("RoyalBlue") square([0.55, 1.0], center = true);
}
module co_icon() { // CO monitor: rounded body + grill dots
    color("DimGray") offset(r = 0.5) square([2.2, 1.4], center = true);
    color("White") for (i = [-1:1]) translate([i * 0.7, 0]) circle(r = 0.18);
}
module sae_icon() { // SAE quick-disconnect: two mating halves
    color("Black") translate([-1.0, 0]) square([1.6, 1.4], center = true);
    color("DimGray") translate([1.0, 0]) square([1.6, 1.4], center = true);
    color("White") square([0.35, 0.8], center = true);
}
module grommet_icon() {
    color("Black") difference() { circle(r = 0.9); circle(r = 0.45); }
}
module enclosure_icon(w = 6, h = 4) { // hinged box, lid seam + latches
    // frame is 4 plain strips, NOT a difference() ring — in preview
    // mode a difference's subtracted interior ghost-occludes any
    // coplanar fill beneath it (renders the whole box black)
    fr = 0.3;
    color("Gainsboro") square([w, h], center = true);
    color("Black") {
        for (sy = [-1, 1]) translate([0, sy * (h - fr)/2]) square([w, fr], center = true);
        for (sx = [-1, 1]) translate([sx * (w - fr)/2, 0]) square([fr, h], center = true);
        translate([-w/2 + 1.2, 0]) square([0.15, h], center = true); // hinge line
    }
    color("DimGray") for (sy = [-1, 1]) translate([w/2 - 0.6, sy * h/4]) square([0.5, 0.9], center = true);
}
module outlet12v_icon() { // factory 12V socket
    color("DimGray") circle(r = 1.1);
    color("Black") circle(r = 0.7);
    color("White") circle(r = 0.2);
}
module outletAC_icon() { // factory household AC duplex outlet, wall-plate style
    color("Gainsboro") square([2.2, 3.0], center = true);
    color("DimGray") for (sy = [-1, 1]) translate([0, sy * 0.75]) {
        square([1.5, 1.1], center = true);
        color("Black") translate([-0.35, 0.15]) square([0.15, 0.5], center = true);
        color("Black") translate([0.35, 0.15]) square([0.15, 0.5], center = true);
        color("Black") translate([0, -0.3]) circle(r = 0.13);
    }
}

// ============================================================
// SECTION 1 — top-down layout
// ============================================================
module section1() {
    // MIRRORED so the bird's-eye orientation is true: tailgate at top
    // -> nose points down the page -> PASSENGER side on the page LEFT.
    translate([panel_width, 0]) mirror([1, 0, 0]) section1_content();
}

module section1_content() {
    y_front = 0;                                   // Panel A flush to the front seatbacks, no open-floor gap
    y_ab = y_front + panel_a_length;               // 29
    y_bc = y_ab + panel_b_length;                  // 58
    y_tg = y_bc + panel_c_length;                  // 94
    W = panel_width;

    rect_outline(W, y_tg);
    mlabel("ELECTRICAL LAYOUT — top-down (front at bottom, tailgate at top)", W/2, y_tg + 3.4, 1.5);
    mlabel("DRIVER side", 6, y_tg + 1.4, 2.0);
    mlabel("PASSENGER side", W - 8, y_tg + 1.4, 2.0);
    color("Silver") for (y = [y_ab, y_bc]) translate([0, y - 0.1]) square([W, 0.2]);
    mlabel("PANEL A", W/2 - 12, (y_front + y_ab)/2 - 3, 2.2);
    mlabel("PANEL B", W/2, (y_ab + y_bc)/2 + 6, 2.2);
    mlabel("PANEL C", 27, y_bc + 5.5, 2.2);

    // kitchen / cabinet / fridge footprints inside Panel C
    color("Gainsboro") translate([W - frame_rail_sz - kitchen_box_width, y_tg - kitchen_hatch_inset - kitchen_box_length]) square([kitchen_box_width - 0.4, kitchen_box_length - 0.4]);
    mlabel("KITCHEN", W - frame_rail_sz - kitchen_box_width/2 - 5, y_tg - kitchen_hatch_inset - kitchen_box_length/2 - 2, 2.0);
    fr_x0 = 1.9;                                   // fridge against the driver-side rear corner leg (1.5in leg + margin)
    color("Silver") translate([fr_x0, y_bc + 0.4]) square([fridge_ext_length - 0.4, fridge_ext_width]);
    mlabel("FRIDGE", fr_x0 + fridge_ext_length/2, y_bc + fridge_ext_width/2, 2.0);
    mlabel("utility bay", 17, y_tg - 4.0, 1.9);

    // Rear-pantry footprint: the prefab drawer cluster ON Panel C's
    // deck, at the tailgate end (last pantry_len of Panel C's own length) —
    // shares the same X-Y footprint as the fridge/kitchen/cabinet
    // above (different Z height), drawn as a distinguishing outline
    hb_y0 = y_tg - pantry_len;
    color("DarkGray") rect_outline(W, pantry_len, 0.15);
    translate([0, hb_y0]) color("DarkGray") square([W, 0.15]); // divider line at the pantry's front edge
    mlabel("REAR PANTRY", W/2, y_tg - pantry_len - 2.4, 2.0);

    // 1: Power strip 1 — on the deck edge in the pantry's OPEN BAY
    // (passenger side, next to the pot crate) — see the Rear Pantry render
    translate([38, hb_y0 + 6]) strip_icon(4);
    mmarker(1, 36, hb_y0 + 10.5);

    // 3: the REAR AC outlet — back passenger area (VERIFIED to exist;
    // exact spot + shared-inverter check in Appendix A/5). Drawn just
    // outside the deck on the passenger wall, near the tailgate.
    translate([W + 5, y_tg - 10]) outletAC_icon();
    mlabel("REAR AC outlet", W + 5, y_tg - 21, 2.0);
    mlabel("(22.5\" up, 10\" in)", W + 5, y_tg - 23.6, 1.9);
    mmarker(3, W + 2, y_tg - 6.5);

    // 2: Power strip 1's cord — a SHORT hop to the rear outlet beside
    // it (the old full-length run to the front console is gone: the
    // rear outlet sits right next to the pantry). No seams crossed.
    ps1_cord = [[38, hb_y0 + 6], [W + 3, y_tg - 9]];
    wire(ps1_cord, 0.3, marker_col(2));
    mmarker(2, 41, hb_y0 - 1);

    // 4: cooktop cord — also a SHORT run to the rear outlet, with a
    // slack loop for the kitchen's slide travel. No seams crossed.
    cord = [[34.5, y_tg - 5.5], [39, y_tg - 7.5], [W + 3, y_tg - 10.5]];
    wire(cord, 0.3, marker_col(4));
    mmarker(4, 41, y_tg - 12.5);

    // front console: ONE AC outlet (1500W verified) — DELTA 3 charging only
    translate([27, -3.5]) outletAC_icon();
    mlabel("front console outlet — DELTA 3 charging", 23, -6.6, 1.9);

    // 5: 2-way tap at the rear outlet — Power strip 1 + the cooktop share it
    translate([W + 5, y_tg - 7.6]) square([3.4, 0.5], center = true);
    mmarker(5, W + 8, y_tg - 10);

    // 6: grommets where the two short AC cords exit the deck edge
    translate([40, hb_y0 + 0.6]) grommet_icon();
    translate([42, y_tg - 6.5]) grommet_icon();
    mmarker(6, 44, hb_y0 - 3);

    // 7: Power strip 2 — mounted ON the slide-out kitchen unit so it
    // travels to the cook position; its cord to the rear outlet keeps
    // a slack loop for the slide travel (Section 5)
    translate([34.5, y_tg - 3.8]) strip_icon(4);
    mmarker(7, 23, y_tg - 2.6);

    // 8: control cluster (no enclosure) — on Panel C's FRONT wall, Panel-B face
    translate([33, y_tg - 1.9]) enclosure_icon(5, 2.6);
    mmarker(8, 32, y_tg - 8.5);

    // 9: intake fan — on Panel C's FRONT wall, over the fridge's B-facing end
    translate([fr_x0 + fridge_ext_length/2, y_bc - 2.6]) fan_icon(1.7);
    mmarker(9, fr_x0 + fridge_ext_length/2 - 6, y_bc - 2.6);

    // 10: exhaust fan (blows into the open bay) + NTC probe (just inside the bay at that wall) — fridge's kitchen-facing side
    translate([fr_x0 - 2.4, y_bc + fridge_ext_width/2 + 4]) fan_icon(1.7);
    color("SeaGreen") translate([fr_x0 - 1.2, y_bc + fridge_ext_width/2 + 8]) circle(r = 0.45);
    mmarker(10, fr_x0 - 7, y_bc + fridge_ext_width/2 + 4);


    // 11+12: fridge DC line — DELTA 3 (Panel A right drawer) forward
    // to the fridge in Panel C, along its own path (offset from the
    // cooktop's rail run at x=42.5) so the two don't overlap. Fridge
    // and fan system both moved off the old factory rear 12V outlet
    // onto the DELTA 3 — see Section 1/5.
    fridge_dc_cord = [[34, 20], [44, y_ab - 3], [44, y_bc + 3], [fr_x0 + 2, y_bc + 3]];
    wire(fridge_dc_cord, 0.3, marker_col(12));
    mmarker(11, 34, 20);
    for (y = [y_ab, y_bc]) translate([44, y]) sae_icon();
    mmarker(12, 47, y_bc - 6);

    // 13: DELTA 3 AC charging cord — the front console's ONE outlet
    // (1500W verified) back to the DELTA 3 in Panel A's right drawer.
    // The cooktop + Power strip 1 use the REAR outlet instead — but
    // both outlets likely share the van's single 1500W inverter, so
    // the wattage budget is still one pool (Section 5).
    delta3_charge_cord = [[34, 20], [28, y_front - 3], [27, -3.5]];
    wire(delta3_charge_cord, 0.3, marker_col(14));
    mmarker(13, 37, y_front + 4);

    // 14: DELTA 3 drawer cord slot — the charging line's exit, cut in the drawer wall (Panel A right drawer)
    translate([34, y_ab - 1.6]) grommet_icon();
    mmarker(14, 34, y_ab - 5);
}

// ============================================================
// SECTION 2 — control cluster elevation (in the open utility bay, on the backer board)
// ============================================================
module section2() {
    z_deck = leg_height + frame_rail_sz; // 18.5
    label("CONTROL CLUSTER — on Panel C's FRONT wall", 23, 36, 2.2);
    rect_outline(30, 33);                              // wall section, x 0-30, z 0-33
    // MOVED TO THE DOCUMENT: label("backer board at the back of the open bay (no door — reach in)", 15, -2.2, 1.0);
    color("Silver") translate([0, z_deck - 0.1]) square([30, 0.2]);
    label_left("deck level", 49, z_deck + 1.1, 1.9);
    label_left("18.5\"", 49, z_deck - 1.3, 1.9);

    // enclosure with the whole cluster inside
    translate([10, z_deck + 4]) {
        enclosure_icon(13, 9);
        translate([-3, 2]) w1209_icon();
        translate([4.2, 2]) fusebox_icon();
        for (i = [0:2]) translate([-4.5 + i * 3.2, -2.6]) switch_icon();
    }

    label_left("A", 3.2, z_deck + 9.5, 2.2);
    label_left("B", 5.5, z_deck + 6.3, 2.2);
    label_left("C", 12.2, z_deck + 7, 2.2);
    label_left("D", 4.2, z_deck - 1.8, 2.2);
    label_left("E", 26.5, 29.5, 2.2);

    // MOVED TO THE DOCUMENT: label_left("A  backer board — 4x #8 x 1\" screws up into the deck underside (the LMioEtool enclosure was deleted Aug 2026)", 34, 31.5, 1.0);
    // MOVED TO THE DOCUMENT: label_left("B  W1209 controller (in its case) — NTC probe wire exits the bottom grommet,", 34, 28.5, 1.0);
    // MOVED TO THE DOCUMENT: label_left("    runs to the fridge's kitchen-facing wall (Section 3)", 34, 26.8, 1.0);
    // MOVED TO THE DOCUMENT: label_left("C  Nilight 6-way fuse block — feed from the DELTA 3's DC output (Panel A); fans + W1209 each", 34, 24.0, 1.0);
    // MOVED TO THE DOCUMENT: label_left("    get their own fused circuit (5A is plenty)", 34, 22.3, 1.0);
    // MOVED TO THE DOCUMENT: label_left("D  3x Ampper switches (fridge / cooktop strip / fans) — 20mm holes in the", 34, 19.5, 1.0);
    // MOVED TO THE DOCUMENT: label_left("    enclosure face, switches snap in from the front", 34, 17.8, 1.0);
}

// ============================================================
// SECTION 3 — fan mounting detail (both fans)
// ============================================================
module section3() {
    // MOVED TO THE DOCUMENT: label("FAN MOUNTING — face-on, both fans identical hardware", 23, 16, 1.4);

    // intake fan, blowing INTO the bay
    translate([8, 4]) {
        fan_icon(4);
        color(marker_col(9)) translate([0, 7]) text("INTAKE", size = 2.6, halign = "center");
        wire([[-8, 0], [-5.6, 0]], 0.35, "Black");
        color("Black") translate([-5.6, 0]) rotate(-90) polygon([[-1, 0], [1, 0], [0, 1.6]]);
        label("cabin air IN", -8, -5.5, 1.9);
    }
    // exhaust fan, blowing OUT into the open bay
    translate([38, 4]) {
        fan_icon(4);
        color(marker_col(10)) translate([0, 7]) text("EXHAUST", size = 2.6, halign = "center");
        wire([[5.6, 0], [8, 0]], 0.35, "Black");
        color("Black") translate([8, 0]) rotate(90) polygon([[-1, 0], [1, 0], [0, 1.6]]);
        label("warm air OUT", 11, -5.5, 1.9);
        color("SeaGreen") translate([6.5, -3.5]) circle(r = 0.5);
        // MOVED TO THE DOCUMENT: label("NTC probe: zip-tie 1-2\" from the exhaust cutout", 8, -6.2, 0.9);
    }

    // MOVED TO THE DOCUMENT: label_left("Cut a 4.5\" round hole (or 4.5\" square) in the wall; fan mounts over it with", 0, -10.5, 1.0);
    // MOVED TO THE DOCUMENT: label_left("4x #8 x 1-1/4\" screws through the corner holes. Grill goes on the AIR-ENTRY side.", 0, -12.4, 1.0);
    // MOVED TO THE DOCUMENT: label_left("Arrow on the fan's side frame shows its blow direction — point it per the labels above.", 0, -14.3, 1.0);
    // MOVED TO THE DOCUMENT: label_left("Wiring: both fans in parallel off the W1209 relay (Section 5 wiring schematic).", 0, -16.2, 1.0);
}

// The 14-row legend that used to sit beside the plan is a table in the
// document under this figure. Its longest row was 126 characters, which set
// this sheet at 158 units wide; printed text height is size x (page_width /
// sheet_width), so its own rows came out near 6pt. Markers 1-14 index it.

// ---- assemble ----------------------------------------------------
section1();
// The two insets go BESIDE the van plan, not under it. Stacked, this sheet was
// 82 x 179 units — so tall and narrow that the page fitted it by HEIGHT and it
// used barely a third of the available width, which is what actually set its
// printed text size. Side by side it comes out near 139 x 106, close to the
// page's own proportions, and the same labels print roughly half again larger.
// Measured extents: section1 x -16..54 / y -7..99, section2 x -9..47 / y 0..37,
// section3 x -4..54 / y -1..14, about their own origins.
translate([69, 60]) section2();
translate([69, 26]) section3();
label("Markers 1-14: see the key under this figure", 24, -13, 2.4);
