jjjjj-enterprises/sienna_camper/kitchen_drawer_detail.scad

// ============================================================
// Kitchen drawer detail — the shallow slide-out drawer hung under
// Panel C's deck in the dead air above the kitchen unit. Two
// dimensioned 2D sections, woodworking-plan style.
// ============================================================
// The kitchen unit is 11.8in tall; Panel C's void is 17in clear
// under the tailgate-face rail. This drawer lives in that gap:
// hung from the deck by two 3/4in ply cheeks, riding a 24in
// full-extension side-mount slide pair, pulling straight out the
// open TAILGATE directly above the kitchen unit. Utensils, cutting
// board, flat dry goods, the cooktop's griddle plate.
//
// Render with: openscad -o renders/kitchen-drawer-detail.svg kitchen_drawer_detail.scad
// ============================================================
// LEGIBILITY (Aug 2026): 9 prose line(s) moved out of this
// sheet into the document, and every text size scaled x2.0. Those
// sentences were setting the sheet's width, and a figure's printed
// text height is size x (page_width / sheet_width) — so they were
// holding every other label on the sheet down to 3-6pt on paper.
// Keep prose in the markdown; this sheet carries geometry and short
// labels only.

include <params.scad>

stroke = 0.2;

z_rail0 = leg_height;                    // 17
z_rail1 = leg_height + frame_rail_sz;    // 18.5
z_deck  = z_rail1;                       // 18.5 — deck surface, recessed flush with the rail tops
z_d0    = kdrawer_z0;                    // 12.3 — drawer underside
z_d1    = kdrawer_z0 + kdrawer_box_h;    // 16.8 — drawer top

module rect_outline(w, h, s = stroke) {
    difference() {
        square([w, h]);
        translate([s, s]) square([w - 2*s, h - 2*s]);
    }
}
module label(txt, x, y, size = 2.4, halign = "center") {
    color("black") translate([x, y]) text(txt, size = size, halign = halign, valign = "center");
}
module dim_v(x, z0, z1, txt, size = 2.2) {
    color("black") {
        translate([x, z0]) square([stroke, z1 - z0]);
        translate([x - 0.8, z0]) square([1.6, stroke]);
        translate([x - 0.8, z1 - stroke]) square([1.6, stroke]);
        label(txt, x + 1.6, (z0 + z1)/2, size, "left");
    }
}
module dim_h(x0, x1, y, txt, size = 2.2) {
    color("black") {
        translate([x0, y]) square([stroke, 1.4], center = true);
        translate([x1, y]) square([stroke, 1.4], center = true);
        translate([x0, y - stroke/2]) square([x1 - x0, stroke]);
        label(txt, (x0 + x1)/2, y - 1.8, size);
    }
}

// ---- view 1: side section (Y-Z), tailgate at right ----
module side_section() {
    ky0 = panel_c_length - kitchen_hatch_inset - kitchen_box_length; // 1.5in in from the tailgate edge
    pull = 5;                                  // drawer drawn part-open

    color("black") {
        translate([-4, -stroke]) square([panel_c_length + 12, stroke]); // floor
        // Panel C legs + rail + deck
        translate([0, 0]) rect_outline(frame_rail_sz, leg_height);
        translate([panel_c_length - frame_rail_sz, 0]) rect_outline(frame_rail_sz, leg_height);
        translate([0, z_rail0]) rect_outline(panel_c_length, frame_rail_sz);
        translate([frame_rail_sz, z_rail1 - panel_thickness]) rect_outline(panel_c_length - 2 * frame_rail_sz, panel_thickness); // deck, recessed between the rails
    }
    // kitchen unit
    color("DimGray") translate([ky0, 0]) rect_outline(kitchen_box_length, kitchen_box_height);
    label("kitchen unit", ky0 + kitchen_box_length/2, kitchen_box_height/2 - 2.5, 2.0);

    // hanging cheek (edge-on, behind the drawer) — dashed top edge zone
    color("Gray") translate([ky0, z_d0]) rect_outline(kdrawer_box_len, z_rail1 - panel_thickness - z_d0); // cheek reaches the recessed deck underside (17.75)
    // the drawer itself, part-open toward the tailgate
    color("black") translate([ky0 + pull, z_d0]) rect_outline(kdrawer_box_len, kdrawer_box_h);
    label("DRAWER", ky0 + pull + kdrawer_box_len/2, (z_d0 + z_d1)/2, 2.0);

    // dims on the left margin
    dim_v(ky0 - 2.5, 0, kitchen_box_height, str(kitchen_box_height, "\""));
    dim_v(ky0 - 2.5, kitchen_box_height, z_d0, "");
    label(str(kdrawer_gap_below, "\" clear"), -1, (kitchen_box_height + z_d0)/2, 2.0, "right");
    dim_v(ky0 - 6.5, z_d0, z_d1, str(kdrawer_box_h, "\""));
    // the clearance this whole drawer exists to fit inside
    label(str("drawer top ", z_d1, "\" — clears the ", z_rail0, "\" rail"),
          panel_c_length/2, z_deck + 4, 2.0);

    label("SIDE SECTION — TAILGATE at right", panel_c_length/2 + 4, -4.2, 2.2);
}
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
