jjjjj-enterprises/sienna_camper/(list of files, cad)

Other CAD files:
measurement_fridge_kitchen.scad
night_cooling_setup_detail.scad
panel_c_wall_detail.scad
panel_detail.scad
platform.scad
rear_view.scad
rear_view_deployed.scad
sheet2d.scad
sheet_cut_layout.scad
side_view.scad
top_view.scad
van_measure_keys.scad
van_plan.scad
view_side.scad
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
