jjjjj-enterprises/sienna_camper/renders/fridge-install-detail.png

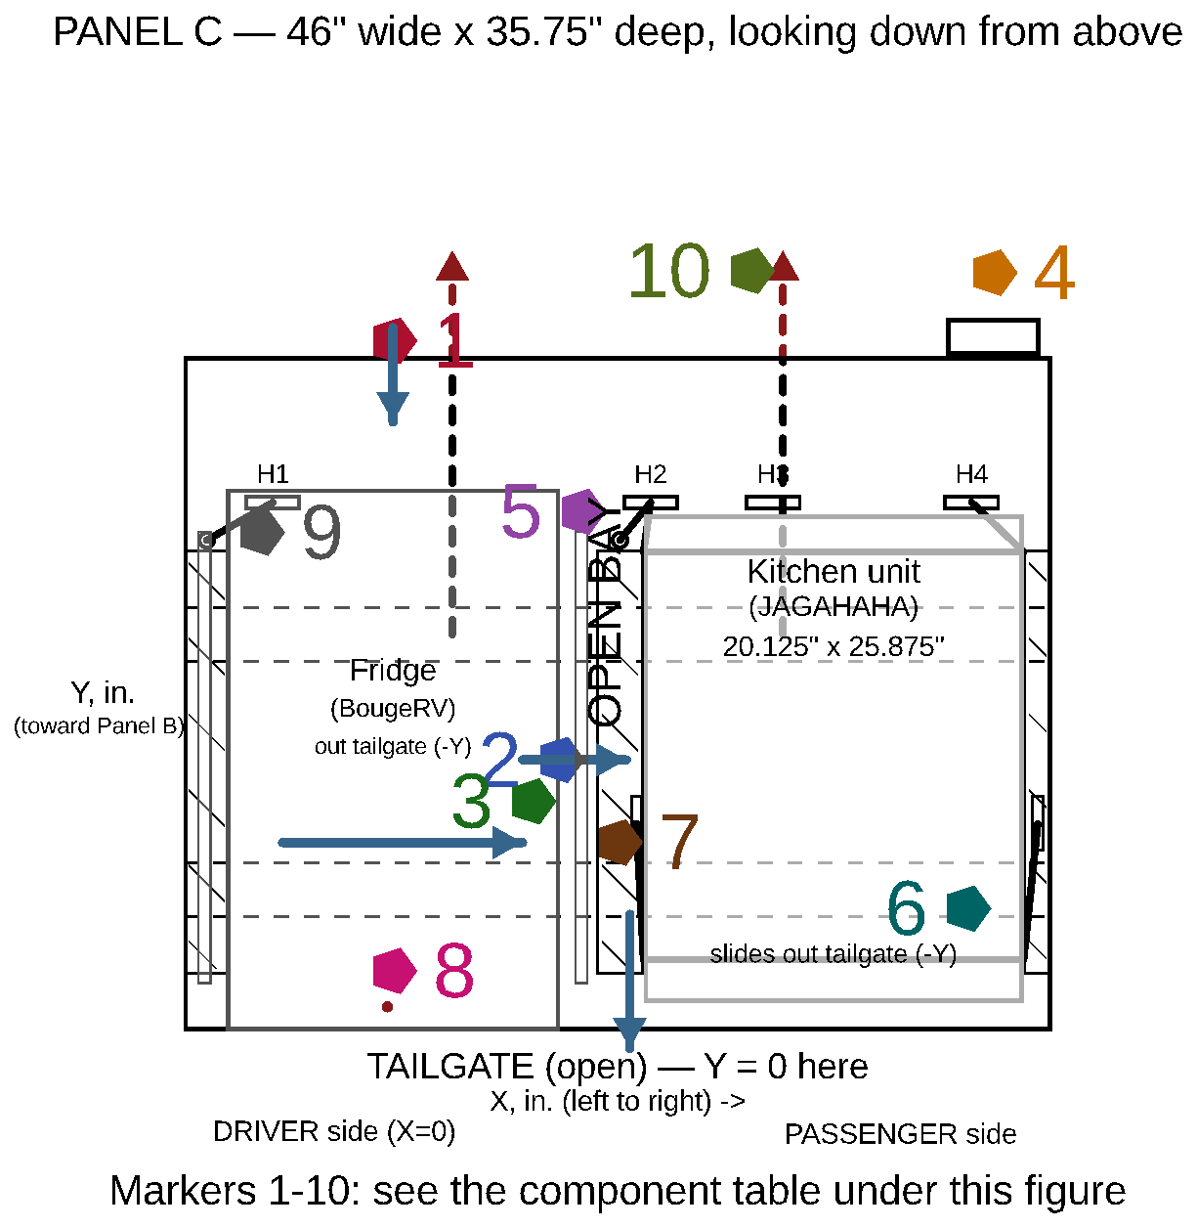
renders/fridge-install-detail.png
