jjjjj-enterprises/sienna_camper/renders/measurement-fridge-kitchen.png

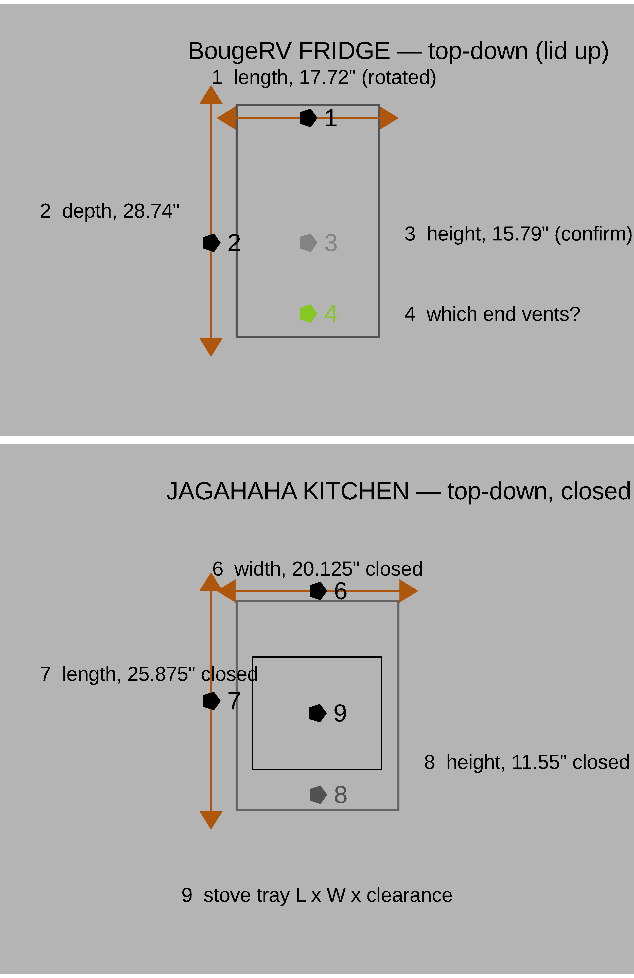
renders/measurement-fridge-kitchen.png
