jjjjj-enterprises/sienna_camper/(commit log)

2026-09-08 Panel A is built: the bench photos, and two screws a corner
    Panel A came together on Sept 7 and the plan now says so. A new section at
    the end of Component 2 -- "Panel A, as actually built" -- carries seven
    photos from the session with captions, PDF pages 57-60. Nothing in it
    changes a dimension, a part or a fastener: the frame went together as
    drawn. What it adds is method, which no exploded view was ever going to
    show.
    WHAT THE PHOTOS SETTLED. Three things the drawings never stated:
    Two screws per corner. The corner close-up shows both, countersunk below
    flush, driven through the outboard end rail's face into the end of the
    side rail. The parts list said "corner brackets and 2-1/2" screw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
2026-09-08 The 2" block is the gap to the side rail, not the leg's inset
    Closing the question 08cf8dc left open. That commit noted the leg-gauge photo
    shows a block marked 2" while the plan puts Panel A's legs 3.5" in from the
    deck's side edges, and said to measure the panel before Panel B got the same
    treatment. Nothing needs measuring: the two numbers describe different spans,
    and both are right.
    leg_inset (3.5") is from the deck's OUTER EDGE to the leg's outer face. The
    2" block is the GAP between the side rail's inner face and that same face.
    The side rail sits flush with the edge, so the block is the inset minus the
    rail. Against the measured 1-7/16" stock that is 3-7/16" of inset, 1/16"
    inside t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
2026-09-11 Cut both sheets: the plywood is down to parts
    Six shop photos and the method behind them, as a new Section 3 subsection.
    Nothing here changes a dimension, a part or an offcut — the sheets broke
    down as drawn. What it adds is how the one shaped cut in the build got made.
    The division of labour was two saws: table saw for every long cut, jigsaw
    for every interior cut. The jigsaw wants a REVERSE-TOOTH blade (Bosch
    T101BR) so the tearout lands on the underside instead of the marked face,
    and its orbital selector set to suit the stock.
    The drill-first rule for the comb's inside corners turns out to pay twice:
    the hole is the ~1/2" fillet AND the jigsaw's entry into the perpendicular
    cut, so i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
2026-09-17 The cut list catches up: it was three corrections behind the plan
    cut_list.html had drifted far enough that cutting from it would have produced
    a panel that doesn't assemble. Every number in it now comes from Section 3 of
    the build plan, which is what the PDF is built from.
    The 2x2 group was the dangerous part:
    - Side rails were listed at the full panel length (29/29/36). They fit BETWEEN
    the end rails, so they lose 1.5" at each end: 26/26/32.75. Cutting them long
    double-books 1.5" at all four corners.
    - Legs were one row of 12 at 16". They are three batches now that the legs are
    lapped: 8 at 16.75" (Panels A/B), 2 at 17.5" (Panel C front), 2 at 16" (the
    only butt-under pair, Panel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
2026-09-17 The battery drawer gets a shop drawing, and it finds five stale dimensions
    The box has shrunk three times -- the deck recess, the lapped legs, and the
    3/8" -> 3/4" wall swap -- and each time the cut sheets lagged a revision
    behind. Drawing the thing to scale is what surfaced how far.
    power_drawer_assembly.html is a new standalone sheet: plan view keyed to a
    parts legend, a section through the height budget, the corner joint, a Panel A
    locator, the cut list, a fit check tracing every number to its source, and the
    assembly order. build_pdf.py now prints it with Chrome and concatenates it onto
    the end of the plan BEFORE stamp_footers runs, so "page N of M" stays
    continuous across the seam -- 1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
2026-09-28 Panels B and C get shop drawings, and both find the plan wrong about the wall and the bearer
    panel_b_assembly.html and panel_c_assembly.html are new standalone sheets in
    the same style as the battery drawer's: plan, sections, details, cut list,
    board-by-board packing, hardware, build order. build_pdf.py appends both after
    the power drawer, so the PDF is now 165 numbered pages.
    Panel B:
    - The centre bearer is DROP-IN (owner, 26 Sept). Screwed in, it split the top
    opening into two 20 1/8 x 26 1/8" holes, and the 28.5" spare can't pass
    either one edge-on (27.0" max). It now rests on 4x 1" zinc corner braces.
    They're 1" and not 1 1/2" because a 1 1/2" upright is taller than the
    1-7/16"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
    [component_headers.scad, delta3_wave3_detail.scad, panel_ab_lego.scad, panel_detail.scad, params.scad, platform.scad, view_side.scad]
2026-10-01 The plan reads as the current build: history out, drawer photos and the pantry mat in
    The owner asked for every historical comment gone, so the PDF says what to
    build rather than how the design got there. Git keeps the old wording.
    Build plan (~10% of the text): former values ("was 26\"..."), dated change
    tags ("(owner, Aug 2026)"), struck-through items, "used to"/"superseded"
    asides, the round-by-round cost history, the "tried and dropped" table (now
    four "don't" rules with one reason each) and the "*(was row #N)*" tags in
    Appendix A. Current numbers, instructions, warnings and the reasons behind
    choices stay, as do purchase and measurement dates (they're status). Every
    table keeps its cel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
2026-10-01 Re-render with OpenSCAD installed: the model checks pass, and nine views catch up
    OpenSCAD 2021.01 is installed, so the .scad edits from the last two commits
    finally ran. params.scad, platform.scad, steps/component_headers.scad and
    panel_c_wall_detail.scad all evaluate cleanly, including the new
    spare-through-opening assert and bottom_side_rail_z.
    render.sh (25 min, exit 0) redrew every view; nine came out different:
    - panel-c-wall-detail: the grommet at 2.25" (pcwall_grommet_x). The render
    still draws the 9 x 2" louver slot and 8 screw dots; the Panel C sheet's
    Fig 3 governs.
    - panel-a-detail, delta3-wave3-detail, comp-2/comp-8 headers: the WAVE 3
    shelf and glide strips are gone.
    -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
2026-10-01 The front-wall render shows the three 3" vents, and its screws match the sheet
    The wall's passive intake is three 3" round holes for the snap-in soffit
    vents the owner already has, not the 9 x 2" slot the render drew. The model
    now defines them: intake_vent_n/_dia/_pitch, centred on the fan's line,
    3.75" apart and 4.125" up. intake_vent_w/_h become the row's bounding box, so
    the existing clearance asserts check it as one opening. Two new asserts keep
    3/4" of ply between holes and the open area above the fan's aperture
    (~21 sq in against 17.7).
    pcwall_z0 = 0.5 records that the wall hangs 1/2" off the floor, and the two
    bottom-rail clearance asserts subtract it. Without it, wall-coordinate
    he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
    [panel_c_wall_detail.scad, params.scad]
2026-10-14 Tongue notches and the fridge tray get shop drawings, and the sheets switch to American spelling
    - New Tongue Notches sheet: 3" notches centered 14¼" and 31¾" from Panel C's
    driver face (cap holes measured 13 Oct), 1" deep in the front wall and ½" in
    the rail, back blocks and Panel B's end rail, every notch top at 1½".
    - New Fridge Tray sheet: panel and aprons cut, glued and screwed.
    - Panel C sheet: built to the deck; steps 1-9 done.
    - Plan text drops the old 3/16" Panel B-only notch and points to the new sheet.
    - Tray sheet records the comb cuts as made (middle strip to 2⅛", crossbar to ~3¼").
    - Shopping list: under-board mat and fridge hold-down.
    - centre/centred/levellers beco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
2026-10-14 The tongue notches are cut, and the plan says to cut them before assembly
    - Tongue Notches sheet: all 8 notches cut 14 Oct; strap notches still wait
    for the D-rings. New first flag: notch the loose parts before assembly.
    - Panel B and C sheets and the plan's frame steps: cut the tongue notches on
    the bench before the rails, blocks and wall go on, and keep every screw out
    of the 12¾–15¾" and 30¼–33¼" bands.
    - PDF rebuilt (183 pages).
2026-10-14 Steel and the last plywood are cut; the plan records the skid, riser and drawer changes
    - Tongues cut to 16" and riser angles to 24". The kitchen riser's flange is
    ripped to 1" to clear the kitchen unit; the driver riser stays 2".
    - Spare skid is now ¾" ply (no 2×2 left): 2 battens 2⅛ × 24 on edge between
    the seat tracks and 3 cleats 3 × 30 across them, 2⅞" tall, clear of the
    tracks, tongues and caps.
    - Kitchen drawer bottom glues and screws on under the walls; no rabbet.
    - Bed cut plan for 6 1×4s plus the 1×3, since one 1×4 became the tray aprons.
    - PDF rebuilt.
2026-10-15 The bed is cut: 6 rails, 5 long slats and 10 short slats from six 1×4s and the 1×3
2026-10-15 The riser angles get a shop sheet, and the sheets read as the final build
    - New Riser Angles sheet: both cut to 24"; driver riser as bought, kitchen
    flange ripped to 1" to clear the kitchen unit; end, section, plan and
    top-of-cut views; holes wait for the anchor board sheet.
    - Fridge Tray sheet: flags restated as the final layout (17⅞" panel, tray
    2½" in from the driver edge, slides on the riser angles), no history.
    - Tongue Notches sheet: tongues cut; the old plan-difference note removed.
    - Plan: fridge tray cut-list row matches the tray as built.
    - PDF rebuilt with the new sheet (189 pages).
2026-10-16 The bed platform gets an assembly sheet, Panel B is marked built, and the bed hardware goes on the shopping list
2026-10-17 The fridge slides get a mounting sheet, and the tray sheet gets the hold-down
    - New Fridge Slides sheet: apron → moving rail → fixed rail → riser →
    T-nuts in the anchor-board strips, with every fastener, the riser drilling
    layout, the T-nut layout and the rail position on the aprons.
    - Fridge Tray sheet: new hold-down section (screw eyes in the kitchen-side
    apron under the end handles, cam strap over the lid).
    - Bed sheet: lumber and length on every piece, 13" plywood spacers drawn
    in each section, glue plus pocket screws at every slat end, crown up,
    and measure the slats before sizing the spacers.
    - Plan: the microwave lives on Panel C's deck above the kitchen drawer.
    - Sh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
2026-10-17 The fridge slides mount whole, as VADANIA's directions show, with their own bolts; the tray hold-down uses the stainless footman loops
2026-10-18 The kitchen drawer and the bench drilling get shop sheets, and the slides sheet follows the real build
    - New Kitchen Drawer sheet: parts, box, corners, section under the deck,
    screw layout through the deck, slide heights, with an 18" front and back
    covering the sides' ends.
    - New Anchor Board Drilling sheet: tongue holes, all 12 T-nuts from the
    board's own edges, the bolt stacks, and pulling the T-nuts in.
    - Fridge Slides sheet: mount the slides whole per VADANIA, fit the tray on
    the bench with the risers on single ½" blocks, mark the T-nuts from the
    risers, the drill bits used, and the as-built ⅝" aprons.
    - Riser drilling layout redrawn with van front and back on every part.
    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
2026-10-19 The anchor board is redesigned: three strips on steel rungs, strapped to the 3rd-row seat-latch hoops
    - New Anchor Board sheet: one-piece plywood strips tied by two 2" × 3/16"
    steel rungs set into their undersides, the risers' T-nuts, shackles in
    the risers' front ends strapped to hoops H1 and H2, kitchen straps to
    H2/H4 and to footman loops, from the 18 Oct van survey.
    - The comb, its crossbar and the steel tongues are gone: the side trim
    closes the van to 42" from 26" forward, and the seat-track caps sit below
    the board. The Anchor Board Drilling and Tongue Notches sheets are retired.
    - Plan Section 8, the overview, the floorplan notes, the fridge and kitchen
    install steps, th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
2026-10-19 The old comb is gone from every sheet, render and figure; the kitchen is drawn at its real size and place; the bed plan says glue and pocket screws
2026-10-19 The van measure sheet is down to the foot test, and the last striker-strap and listing-size lines follow the new board
2026-10-19 The anchor board takes 3" steel rungs, chains its risers to the seat hoops with eye bolts, and its strips end at 25½"; the shopping list follows
2026-10-24 Panel C gets side braces at 12½"; the anchor board's chains wrap the ⅝" hoop bars with quick links instead of shackles, and its rungs get rust-proofed
    - Panel C: a 29½" 2×2 brace each side from the rear corner leg to a 4⅞" block on the wall, fixed with 3" SPAX; new Figs 6–10, cut list, hardware and build step; in the model, renders, build plan and weight budget (+2.5 lb)
    - Anchor board: rust-proofing step for the rungs; shackles dropped (hoop bars are ⅝"), 4 quick links and 2 ft of chain; hoop drop 1⅞" loaded, chains tensioned with the fridge in
    - Van measure sheet: hoop-drop measurements (D, T, G, E, F), all recorded
    - Kitchen drawer sheet and build plan: squared-unit hanging m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
2026-10-26 The anchor board's rungs take 4 screws per crossing on the driver and middle strips, the kitchen rear strap anchors to an eye bolt in the kitchen riser, and the comb cut-down sheet is added; the PDF 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
2026-10-30 The rear pantry is now one 27-gallon tote strapped with the microwave to footman loops on Panel C's side rails, the DELTA 3 drawer holds its units on a rubber mat with no cleats and gets a turn butto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
2026-10-30 The tote strap-anchor sheet gets a to-scale end view of the tote and microwave with the strap path, the rail detail shows the tote broken off instead of 3" tall, and the side view draws the tote's bo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
2026-10-31 The fridge bay drops its exhaust fan for one intake fan in the existing hole on M4 x 50mm bolts, moves the control cluster to the front wall's driver column with the W1209 in mode C and the probe at 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
2026-10-31 The wiring diagram shows the fridge socket's place on the driver fixed rail, the probe run is corrected to about 4-1/2 ft for the 2 ft stock lead with a 2 m plug-in probe to buy, the switch plate she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
2026-11-01 The shopping list marks the M4 bolts bought, drops the second magnetic catch, cam strap, hold-down sets and Sterilite totes as not needed, and links the Everbilt #8 x 2-1/4 inch screws for the switch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
2026-11-01 Panel B is shortened to 24 inches for an 88.75 inch platform because the front seats had been assumed all the way forward, Panels A and B come up with longer legs in the plan and a new Bed Risers she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
2026-11-02 The fridge-bay wiring diagram is corrected to the Nilight block as metered (fused outputs on the separate-screw row, negative on the continuous strip) with every other wire dashed, a new Fig 7 draws 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
2026-11-08 The Bed Risers sheet becomes Floor Runners because the floor padding squishes under the feet: two 34 inch glued and screwed 2x6, 2x6 and 1x6 runners under Panel A and Panel B's windshield-end legs wi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
2026-11-08 Shop photos from the bench in every built section, and the PDF stops dropping Component 7 onward
    44 photos from the Oct-Nov work, as 'as actually built' blocks: the bed
    platform (spacers, clamping, the Kreg jig, all three pieces), the battery
    drawer from above, Panel C (front wall, braces, the mat on Velcro), the
    anti-rattle Velcro and carpet end caps, the fridge line's channel, the
    anchor board (rungs, grooves, neoprene, van test fit), the fridge slides
    and riser hold-downs, the kitchen tie-downs and kitchen drawer, and the
    fridge bay's fan cooling.
    Component 7's step 1 was missing a closing </div>. Every step after it
    nested inside it, and the markdown after that point printed as raw text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
2026-11-08 The shopping list marks the hose clamps bought
2026-11-09 Port the Oct 1 drawer and neoprene notes: no grommet, no top tray, two neoprene rolls
    These were committed on Oct 1 but never pushed, and the remote moved on
    (old commits kept on backup/oct1-unpushed). Reapplied to the current text:
    - No grommet in the DELTA 3 drawer. The charging line leaves through the
    cord slot cut in the wall before glue-up. Out of the BOM row, Panel A's
    parts list and step 4, the electrical legend (14), both power-drawer
    sheets (the plan view draws a slot) and the shopping list.
    - No top tray. Its BOM row and the Component 8 entry go, and the stowage
    render is redrawn with its markers renumbered 1-5. delta3_tray_h is gone
    from params.scad. That render's DELTA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
2026-11-09 Mark the plan as a work-in-progress draft
    Dated WIP notice on the cover, 'Work-in-progress draft' on the title page,
    and 'DRAFT, in progress' in every page footer. Tightened the cover so it
    fits on one page again; it had been spilling onto a second page that was
    numbered as page 1.
2026-11-10 The anchor board's hold-downs are recorded as built: eye bolt, one quick link, a short quarter-inch chain of one link at H2 and two at H1, and an anchor shackle around the hoop bar with its pin wired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
2026-11-10 The fridge tray gets a removable leg for when it is pulled out: a 24-1/2 inch 2x2 with a leveling foot that screws up into a flush T-nut 2 inches in from the tray's outer end on a hanger bolt, for th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
2026-11-10 The fridge leg gets a detailed figure: the leg centered under the pulled-out tray, the top joint at four times size with the T-nut flange counterbored flush and the hanger bolt's 7/16 inch of machine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
2026-11-10 The shopping list links the Everbilt 5/16-18 x 3 inch hanger bolt for the fridge leg and marks its T-nut and leveling foot on hand
2026-11-10 The fridge leg becomes a Benro A38FD monopod with flip locks and a fold-out base, screwed into a flush 3/8-16 T-nut in the tray for plenty of height adjustment on uneven ground; Section I of the Frid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
2026-11-10 The FRIDGE and FANS switch plate moves to the hatch end, hung by Velcro on Panel C's driver rear leg or a nearby 2x2, on a plug-in harness of leftover 16AWG red/black cord run inside the fridge bay; 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
2026-11-10 The shopping list adds the heat-shrink spade kit and split loom for the moved switch harness
2026-11-12 The 11 Nov progress photos go into the plan: the four seam clamps in the van under Component 5, the power path from the van's front outlet to the fridge in order under Component 6 (the DELTA 3 charge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
2026-11-12 The Camco 55233 30A-to-household adapter is bought for pedestals with only a 30A outlet; it joins the BOM under the HDX reel, and the shopping list gains both the adapter and the HDX reel; the PDF is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
2026-11-12 The cab blackout curtain and tension rod are dropped from the plan (Component 10, the BOM, the build sequence and the shopping list), and the spare tire now rides outside on the bike rack or a roof c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
2026-11-12 The spare tire rides in the hitch bike rack's second tray, strapped down, and moves to a roof carrier when a second bike joins: the change note, Panel B's description, the stowage table, Component 3'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
2026-11-12 Appendix J: WAVE 3 window vent panel (draft) with a printable measuring sheet
2026-11-13 WAVE 3 window vent: template sheet with closing steps, full-size tiled pattern PDF and its generator
    Template sheet: mark-out, window fit, swing-in, steps and fit record. New steps for closing the glass on the panel (no auto-up, stop 1/2 in. short, very short taps, held not squeezed) and for removal (glass down first, never open the slider with the panel in). Pattern: 8 Letter tiles with trim lines, overlap strips and taping guides on the backs, for duplex printing at 100%.
