jjjjj-enterprises/sienna_camper/(notices)

Notices in the files:
sienna_camper_build_plan.md:
License:
This build plan, its diagrams, and all accompanying project files (the "Materials") are © 2026 JJJJJ Enterprises, LLC and are licensed under the **Creative Commons Attribution-NonCommercial-ShareAlike 4.0 International License** (CC BY-NC-SA 4.0, https://creativecommons.org/licenses/by-nc-sa/4.0/). The full legal text is in the LICENSE file at https://github.com/jjjjj-enterprises/sienna_camper.
- You may view, copy, print, share, build from, and adapt the Materials for personal, **non-commercial** purposes.
- You must give **credit** (Project S'mores / JJJJJ Enterprises, LLC, with a link ba
- If you publish an adapted version, you must **share it under the same license**.
Contributions.** Corrections and build reports are welcome at https://github.com/jjjjj-enterprises/sienna_camper (see CONTRIBUTING.md there). Contributions are accepted under the same CC BY-NC-SA 4.0 license.
